eSpark-Consulting-Group/kurtvogel-athletitech-hw/docs/Client-Files/Original Design/Athletitech/AthletitechTop.png

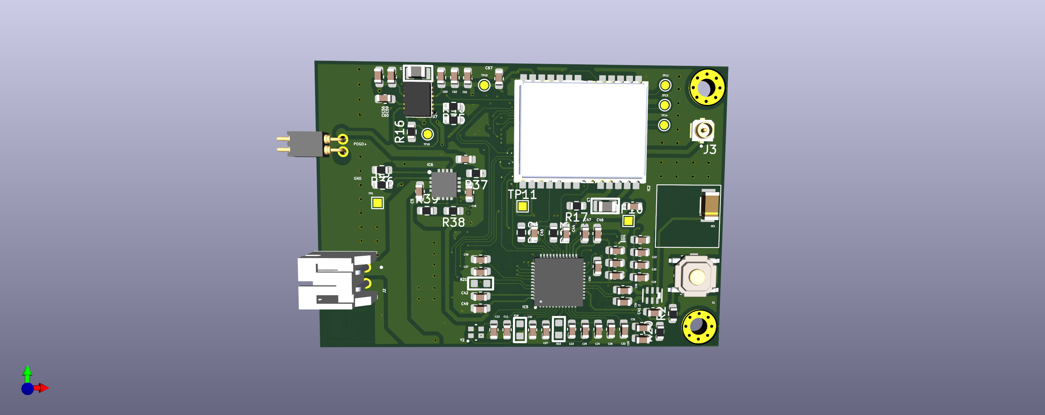
docs/Client-Files/Original Design/Athletitech/AthletitechTop.png
