eSpark-Consulting-Group/kurtvogel-athletitech-hw/docs/Client-Files/Original Design/Athletitech/AthletitechSide.png

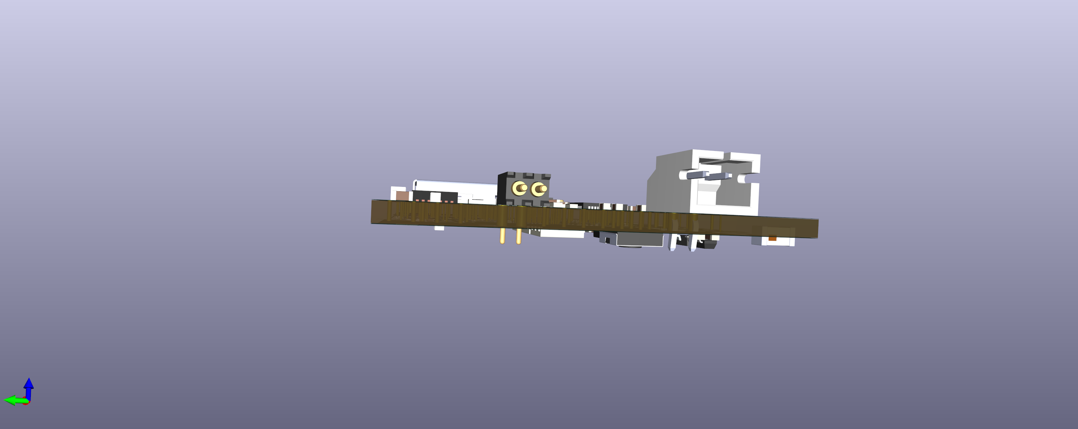
docs/Client-Files/Original Design/Athletitech/AthletitechSide.png
