eSpark-Consulting-Group/kurtvogel-athletitech-hw/README.md

# Athletitech Product Hardware Development and Enhancements
#### Client Name: Kurt Vogel

## Project Requirements
Outlined in Tickets
