eSpark-Consulting-Group/kurtvogel-athletitech-hw/docs/Client-Files/Original Design/Athletitech/AthletitechBottom.png

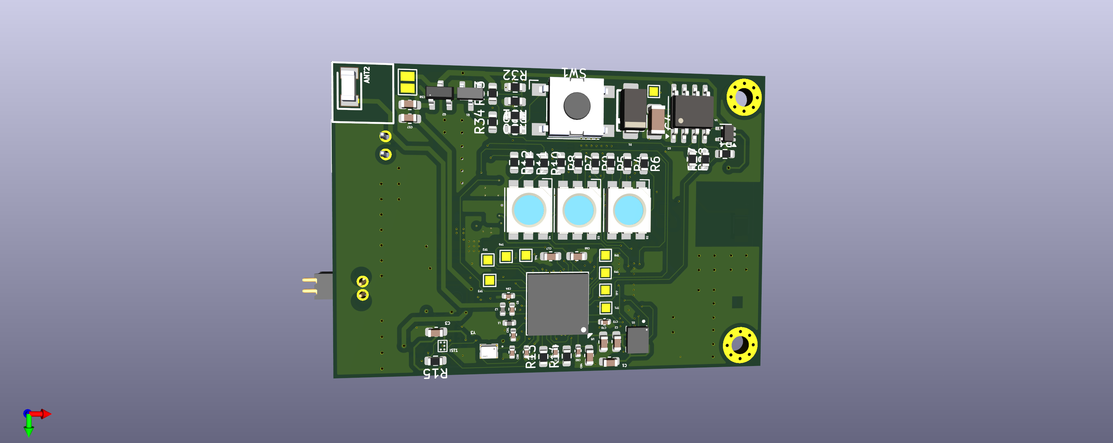
docs/Client-Files/Original Design/Athletitech/AthletitechBottom.png
