eSpark-Consulting-Group/kurtvogel-athletitech-hw/docs/Client-Files/Original Design/Athletitech/pcbway_production/2025-01-10-14-01-19/Athletitech.kicad_pcb_bom.csv

Designator | Quantity | Value | Footprint | Package | MPN | DNP | Mount_Type | MANUFACTURER_NAME | MF | MOUSER_PRICE-STOCK | DESCRIPTION | MOUSER_PART_NUMBER | Price | Check_prices | HEIGHT | MP | SnapEDA_Link | ARROW_PRICE-STOCK | ARROW_PART_NUMBER | Description_1 | Availability | MANUFACTURER_PART_NUMBER | Description | Field4 | Field5 | Field6 | Field7 | Field8 | Part Description | Digikey | LCSC Part # | Manufacturer | Height | Manufacturer_Name | Mouser Part Number | Mouser Price/Stock | Arrow Part Number | Arrow Price/Stock | Purchase-URL | Sim.Device | Sim.Type | Sim.Pins | PARTREV | STANDARD | MAXIMUM_PACKAGE_HEIGHT | MANUFACTURER | MNP
ANT2 | 1 | 2450AT18B100E | ANTC3216X140N | None |  |  | smt | JOHANSON TECHNOLOGY | Johanson | https://www.mouser.co.uk/ProductDetail/Johanson-Technology/2450AT18B100E?qs=yCnrNFeXz%252Bh5MFsFIXGZGA%3D%3D | Antennas 2.45GHz ANTENNA | 609-2450AT18B100E | None | https://www.snapeda.com/parts/2450AT18B100E/AN/view-part/?ref=eda | 1.4mm | 2450AT18B100E | https://www.snapeda.com/parts/2450AT18B100E/AN/view-part/?ref=snap | https://www.arrow.com/en/products/2450at18b100e/johanson-dielectrics?region=nac | 2450AT18B100E | Antenna Chip -0.5dBi Gain 2500MHz 2-Pin CSMD T/R | In Stock | 2450AT18B100E
C1, C2, C3, C43 | 4 | 100nF | C_0402_1005Metric |  |  |  | smt |  |  |  |  |  |  |  |  |  |  |  |  |  |  |  | Unpolarized capacitor, small symbol | Farnell | 2611911 | RM EMK105 B7104KV-F | TAIYO YUDEN EUROPE GMBH | 110091611 | 0.1uF 10% 16V Ceramic Capacitor X7R 0402 (1005 Metric)
C11, C12 | 2 | 10pF | C_0402_1005Metric |  | 04025C222K4T4A |  | smt |  |  |  |  |  |  |  |  |  |  |  |  |  |  |  |  | Farnell | 2611911 | RM EMK105 B7104KV-F | TAIYO YUDEN EUROPE GMBH | 110091611 | 0.1uF 10% 16V Ceramic Capacitor X7R 0402 (1005 Metric)
C17, C66 | 2 | 4.7uF | C_0402_1005Metric |  | C1005X7R1C104K050BC |  | smt |  |  |  |  |  |  |  |  |  |  |  |  |  |  |  | Unpolarized capacitor, small symbol | Farnell | 2611911 | RM EMK105 B7104KV-F | TAIYO YUDEN EUROPE GMBH | 110091611 | 0.1uF 10% 16V Ceramic Capacitor X7R 0402 (1005 Metric)
C18, C67 | 2 | 100nf | C_0402_1005Metric |  | C1005X7R1C104K050BC |  | smt |  |  |  |  |  |  |  |  |  |  |  |  |  |  |  | Unpolarized capacitor, small symbol | Farnell | 2611911 | RM EMK105 B7104KV-F | TAIYO YUDEN EUROPE GMBH | 110091611 | 0.1uF 10% 16V Ceramic Capacitor X7R 0402 (1005 Metric)
C19 | 1 | 47uf | C_0402_1005Metric |  | JMK316ABJ476ML8T |  | smt |  |  |  |  |  |  |  |  |  |  |  |  |  |  |  | Unpolarized capacitor, small symbol | Farnell | 2611911 | RM EMK105 B7104KV-F | TAIYO YUDEN EUROPE GMBH | 110091611 | 0.1uF 10% 16V Ceramic Capacitor X7R 0402 (1005 Metric)
C20, C24, C26, C32, C33, C37, C38, C39, C42, C44, C45, C46, C47, C49 | 14 | 100nf | C_0402_1005Metric |  | TMK105B7104KVHF |  | smt |  |  |  |  |  |  |  |  |  |  |  |  |  |  |  | Unpolarized capacitor, small symbol | Farnell | 2611911 | RM EMK105 B7104KV-F | TAIYO YUDEN EUROPE GMBH | 110091611 | 0.1uF 10% 16V Ceramic Capacitor X7R 0402 (1005 Metric)
C22, C34 | 2 | 10pf | C_0402_1005Metric |  | KGM05ACG1H100JH |  | smt |  |  |  |  |  |  |  |  |  |  |  |  |  |  |  | Unpolarized capacitor, small symbol | Farnell | 2611911 | RM EMK105 B7104KV-F | TAIYO YUDEN EUROPE GMBH | 110091611 | 0.1uF 10% 16V Ceramic Capacitor X7R 0402 (1005 Metric)
C23 | 1 | 27pf | C_0402_1005Metric |  | VJ0402A270JXQPW1BC |  | smt |  |  |  |  |  |  |  |  |  |  |  |  |  |  |  | Unpolarized capacitor, small symbol | Farnell | 2611911 | RM EMK105 B7104KV-F | TAIYO YUDEN EUROPE GMBH | 110091611 | 0.1uF 10% 16V Ceramic Capacitor X7R 0402 (1005 Metric)
C25 | 1 | 1P2 | C_0402_1005Metric |  | GRM0225C1H1R2CA03L |  | smt |  |  |  |  |  |  |  |  |  |  |  |  |  |  |  | Unpolarized capacitor, small symbol | Farnell | 2611911 | RM EMK105 B7104KV-F | TAIYO YUDEN EUROPE GMBH | 110091611 | 0.1uF 10% 16V Ceramic Capacitor X7R 0402 (1005 Metric)
C27, C30, C60 | 3 | 100nF | C_0402_1005Metric |  | CL10B104KA8WPNC |  | smt |  |  |  |  |  |  |  |  |  |  |  |  |  |  |  | Unpolarized capacitor, small symbol | Farnell | 2611911 | RM EMK105 B7104KV-F | TAIYO YUDEN EUROPE GMBH | 110091611 | 0.1uF 10% 16V Ceramic Capacitor X7R 0402 (1005 Metric)
C28, C40 | 2 | 330pf | C_0402_1005Metric |  | MAASU105SB7331KFCA01 |  | smt |  |  |  |  |  |  |  |  |  |  |  |  |  |  |  | Unpolarized capacitor, small symbol | Farnell | 2611911 | RM EMK105 B7104KV-F | TAIYO YUDEN EUROPE GMBH | 110091611 | 0.1uF 10% 16V Ceramic Capacitor X7R 0402 (1005 Metric)
C29 | 1 | 820pf | C_0402_1005Metric |  | UMK105B7821KV-F |  | smt |  |  |  |  |  |  |  |  |  |  |  |  |  |  |  | Unpolarized capacitor, small symbol | Farnell | 2611911 | RM EMK105 B7104KV-F | TAIYO YUDEN EUROPE GMBH | 110091611 | 0.1uF 10% 16V Ceramic Capacitor X7R 0402 (1005 Metric)
C31 | 1 | 18pf | C_0402_1005Metric |  | VJ0402A180KXQCW1BC |  | smt |  |  |  |  |  |  |  |  |  |  |  |  |  |  |  | Unpolarized capacitor, small symbol | Farnell | 2611911 | RM EMK105 B7104KV-F | TAIYO YUDEN EUROPE GMBH | 110091611 | 0.1uF 10% 16V Ceramic Capacitor X7R 0402 (1005 Metric)
C35, C36, C68, C69 | 4 | 12pf | C_0402_1005Metric |  | CBR04C120J5GACAUTO |  | smt |  |  |  |  |  |  |  |  |  |  |  |  |  |  |  | Unpolarized capacitor, small symbol | Farnell | 2611911 | RM EMK105 B7104KV-F | TAIYO YUDEN EUROPE GMBH | 110091611 | [C35,C36] 0.1uF 10% 16V Ceramic Capacitor X7R 0402 (1005 Metric); [C68,C69]0.1 µF ±10% 16V Ceramic Capacitor X7R 0402 (1005 Metric) | 587-1451-1-ND | C385888 | Taiyo Yuden
C4 | 1 | 1uF | C_1206 |  |  |  | smt |  |  |  |  |  |  |  |  |  |  |  |  |  |  |  | Polarized capacitor
C41 | 1 | 10000pf | C_0402_1005Metric |  | KAM05AR71E103KH |  | smt |  |  |  |  |  |  |  |  |  |  |  |  |  |  |  | Unpolarized capacitor, small symbol | Farnell | 2611911 | RM EMK105 B7104KV-F | TAIYO YUDEN EUROPE GMBH | 110091611 | 0.1uF 10% 16V Ceramic Capacitor X7R 0402 (1005 Metric)
C48, C5 | 2 | 470nF | C_0402_1005Metric |  |  |  | smt |  |  |  |  |  |  |  |  |  |  |  |  |  |  |  | Unpolarized capacitor, small symbol | Farnell | 2611911 | RM EMK105 B7104KV-F | TAIYO YUDEN EUROPE GMBH | 110091611 | 0.1uF 10% 16V Ceramic Capacitor X7R 0402 (1005 Metric)
C56, C59 | 2 | 10uF | C_0402_1005Metric |  | CL10A106MQ8NNNC |  | smt |  |  |  |  |  |  |  |  |  |  |  |  |  |  |  | Unpolarized capacitor, small symbol | Farnell | 2611911 | RM EMK105 B7104KV-F | TAIYO YUDEN EUROPE GMBH | 110091611 | 0.1uF 10% 16V Ceramic Capacitor X7R 0402 (1005 Metric)
C57 | 1 | 10uF/25V | C_0402_1005Metric |  |  |  | smt |  |  |  |  |  |  |  |  |  |  |  |  |  |  |  | Unpolarized capacitor, small symbol | Farnell | 2611911 | RM EMK105 B7104KV-F | TAIYO YUDEN EUROPE GMBH | 110091611 | 0.1uF 10% 16V Ceramic Capacitor X7R 0402 (1005 Metric)
C58 | 1 | 0.1uF/25V | C_0402_1005Metric |  | CL10B104KA8NFNC |  | smt |  |  |  |  |  |  |  |  |  |  |  |  |  |  |  | Unpolarized capacitor, small symbol | Farnell | 2611911 | RM EMK105 B7104KV-F | TAIYO YUDEN EUROPE GMBH | 110091611 | 0.1uF 10% 16V Ceramic Capacitor X7R 0402 (1005 Metric)
C6 | 1 | 1.2pF | C_0402_1005Metric |  | CC0402DRNPO9BN5R0 |  | smt |  |  |  |  |  |  |  |  |  |  |  |  |  |  |  | Unpolarized capacitor, small symbol | Farnell | 2611911 | RM EMK105 B7104KV-F | TAIYO YUDEN EUROPE GMBH | 110091611 | 0.1 µF ±10% 16V Ceramic Capacitor X7R 0402 (1005 Metric) | 587-1451-1-ND | C385888 | Taiyo Yuden
C61, C62, C63 | 3 | 22uf | C_0402_1005Metric |  | LMK212BBJ226MG-T |  | smt |  |  |  |  |  |  |  |  |  |  |  |  |  |  |  | Unpolarized capacitor, small symbol | Farnell | 2611911 | RM EMK105 B7104KV-F | TAIYO YUDEN EUROPE GMBH | 110091611 | 0.1uF 10% 16V Ceramic Capacitor X7R 0402 (1005 Metric)
C64 | 1 | 820pF | C_0402_1005Metric |  | CC0402DRNPO9BN5R0 |  | smt |  |  |  |  |  |  |  |  |  |  |  |  |  |  |  | Unpolarized capacitor, small symbol | Farnell | 2611911 | RM EMK105 B7104KV-F | TAIYO YUDEN EUROPE GMBH | 110091611 | 0.1 µF ±10% 16V Ceramic Capacitor X7R 0402 (1005 Metric) | 587-1451-1-ND | C385888 | Taiyo Yuden
C7, C8, C9 | 3 | 0.1uF | C_0402_1005Metric |  | CC0402DRNPO9BN5R0 |  | smt |  |  |  |  |  |  |  |  |  |  |  |  |  |  |  | Unpolarized capacitor, small symbol | Farnell | 2611911 | RM EMK105 B7104KV-F | TAIYO YUDEN EUROPE GMBH | 110091611 | 0.1uF 10% 16V Ceramic Capacitor X7R 0402 (1005 Metric)
C70 | 1 | 1uF | C_0402_1005Metric |  | CC0402DRNPO9BN5R0 |  | smt |  |  |  |  |  |  |  |  |  |  |  |  |  |  |  | Unpolarized capacitor, small symbol | Farnell | 2611911 | RM EMK105 B7104KV-F | TAIYO YUDEN EUROPE GMBH | 110091611 | 0.1uF 10% 16V Ceramic Capacitor X7R 0402 (1005 Metric)
C71, C82 | 2 | NC | C_0402_1005Metric |  | CC0402DRNPO9BN5R0 |  | smt |  |  |  |  |  |  |  |  |  |  |  |  |  |  |  | Unpolarized capacitor, small symbol | Farnell | 2611911 | RM EMK105 B7104KV-F | TAIYO YUDEN EUROPE GMBH | 110091611 | 0.1 µF ±10% 16V Ceramic Capacitor X7R 0402 (1005 Metric) | 587-1451-1-ND | C385888 | Taiyo Yuden
C72 | 1 | 100nF | C_0402_1005Metric |  | CC0402DRNPO9BN5R0 |  | smt |  |  |  |  |  |  |  |  |  |  |  |  |  |  |  | Unpolarized capacitor, small symbol | Farnell | 2611911 | RM EMK105 B7104KV-F | TAIYO YUDEN EUROPE GMBH | 110091611 | 0.1 µF ±10% 16V Ceramic Capacitor X7R 0402 (1005 Metric) | 587-1451-1-ND | C385888 | Taiyo Yuden
C81 | 1 | 100pf | C_0402_1005Metric |  | CC0402DRNPO9BN5R0 |  | smt |  |  |  |  |  |  |  |  |  |  |  |  |  |  |  | Unpolarized capacitor, small symbol | Farnell | 2611911 | RM EMK105 B7104KV-F | TAIYO YUDEN EUROPE GMBH | 110091611 | 0.1 µF ±10% 16V Ceramic Capacitor X7R 0402 (1005 Metric) | 587-1451-1-ND | C385888 | Taiyo Yuden
C84 | 1 | 1uF | C_0402_1005Metric |  | C1005X7R1C104K050BC |  | smt |  |  |  |  |  |  |  |  |  |  |  |  |  |  |  | Unpolarized capacitor, small symbol | Farnell | 2611911 | RM EMK105 B7104KV-F | TAIYO YUDEN EUROPE GMBH | 110091611 | 0.1uF 10% 16V Ceramic Capacitor X7R 0402 (1005 Metric)
D1 | 1 | B120-E3 | D_SMA |  |  |  | smt |  |  |  |  |  |  |  |  |  |  |  |  |  |  |  | 20V 1A Schottky Barrier Rectifier Diode, SMA(DO-214AC)
D2, D3, D4 | 3 | SMD-LX5050RGB-TR | LED_RGB_5050-6 |  |  |  | smt
IC2 | 1 | NEO-M9N-00B | NEOM9N00B |  | NEO-M9N-00B |  | smt |  |  |  |  |  |  |  |  |  |  |  |  |  |  |  | M9 RF Receiver BeiDou, Galileo, GLONASS, GNSS, GPS -167dBm Module |  |  |  |  |  |  |  |  |  | 2.6 | u-blox | 377-NEO-M9N-00B | https://www.mouser.co.uk/ProductDetail/u-blox/NEO-M9N-00B?qs=DPoM0jnrROVeJ6BHpcwcjw%3D%3D | NEO-M9N-00B | https://www.arrow.com/en/products/neo-m9n-00b/u-blox?utm_currency=USD&region=nac
IC5 | 1 | DW1000-I-TR13 | QFN40P600X600X90-49N-D |  | DW1000-I-TR13 |  | smt |  |  |  |  |  |  |  |  |  |  |  |  |  |  |  |  |  |  |  |  |  |  |  |  |  | 0.9 | Qorvo | 772-DW1000-I-TR13 | https://www.mouser.co.uk/ProductDetail/Qorvo/DW1000-I-TR13?qs=TiOZkKH1s2SHqHtNDSAfuQ%3D%3D
IC6 | 1 | BQ24075RGTT | QFN50P300X300X80-17N-D |  | BQ24075RGTT |  | smt |  |  |  |  |  |  |  |  |  |  |  |  |  |  |  | 1.5A Li-Ion Charger, Power-Path VQFN16EP BQ24075RGTT, Battery Charge Controller, Lithium-Ion, 4500mA, 16-Pin QFN |  |  |  |  |  |  |  |  |  | 0.8 | Texas Instruments | 595-BQ24075RGTT | https://www.mouser.co.uk/ProductDetail/Texas-Instruments/BQ24075RGTT?qs=XGzIaZb%2FFYI%2FchYUGCJQgg%3D%3D | BQ24075RGTT | null?region=nac
J2 | 1 | S2B-PH-K-S | S2BPHKS |  | S2B-PH-K-S |  | tht |  |  |  |  |  |  |  |  |  |  |  |  |  |  |  | CONN HEADER R/A 2POS 2MM |  |  |  |  |  |  |  |  |  | 4.8 | JST (JAPAN SOLDERLESS TERMINALS)
J3 | 1 | CONMHF4-SMD-G-T | LINX_CONMHF4-SMD-G-T | None |  |  | smt |  | TE Connectivity |  |  |  | None | https://www.snapeda.com/parts/CONMHF4-SMD-G-T/TE+Connectivity/view-part/?ref=eda |  | CONMHF4-SMD-G-T | https://www.snapeda.com/parts/CONMHF4-SMD-G-T/TE+Connectivity/view-part/?ref=snap |  |  | MHF4 Jack 50 Ohm PCB Surface Mount | In Stock |  |  |  |  |  |  |  |  |  |  |  |  |  |  |  |  |  | https://www.snapeda.com/api/url_track_click_mouser/?unipart_id=9180174&manufacturer=Linx Technologies Inc.&part_name=CONMHF4-SMD-G-T&search_term=None
JP1 | 1 | Jumper_2_Open | SolderJumper-2_P1.3mm_Open_Pad1.0x1.5mm |  |  |  | tht |  |  |  |  |  |  |  |  |  |  |  |  |  |  |  | Jumper, 2-pole, open
L1 | 1 | 2.7nH | L_0402_1005Metric |  | MHQ1005P4N7ST000 |  | smt |  |  |  |  |  |  |  |  |  |  |  |  |  |  |  | Inductor, small symbol
L2 | 1 | 3.3nH | L_0402_1005Metric |  | MHQ1005P4N7ST000 |  | smt |  |  |  |  |  |  |  |  |  |  |  |  |  |  |  | Inductor, small symbol
L3 | 1 | 27nH | C_0402_1005Metric |  | MHQ1005P4N7ST000 |  | smt |  |  |  |  |  |  |  |  |  |  |  |  |  |  |  | Inductor, small symbol | Farnell | 2611911 | RM EMK105 B7104KV-F | TAIYO YUDEN EUROPE GMBH | 110091611 | 0.1uF 10% 16V Ceramic Capacitor X7R 0402 (1005 Metric)
L5 | 1 | 1.5uH | L_0805 |  | 0805LS-102XJRC |  | smt |  |  |  |  |  |  |  |  |  |  |  |  |  |  |  | Inductor
Q1 | 1 | FDN337N | SOT23-3 |  | FDN337N |  | smt |  |  |  |  |  |  |  |  |  |  |  |  |  |  |  |  |  |  |  |  |  |  |  |  |  | 1.12 | onsemi | 512-FDN337N | https://www.mouser.co.uk/ProductDetail/onsemi-Fairchild/FDN337N?qs=FOlmdCx%252BAA3j%252BaaebyVFog%3D%3D
Q2 | 1 | NTR4101PT1G | SOT23-3 |  |  |  | smt |  |  |  |  |  |  |  |  |  |  |  |  |  |  |  | P-MOSFET transistor, drain/source/gate |  |  |  |  |  |  |  |  |  |  |  |  |  |  |  |  | PMOS | VDMOS | 1=D 2=G 3=S
R1 | 1 | 1k | C_0402_1005Metric |  | CRCW040210K0FKEDC |  | smt |  |  |  |  |  |  |  |  |  |  |  |  |  |  |  |  | Farnell | 2611911 | RM EMK105 B7104KV-F | TAIYO YUDEN EUROPE GMBH | 110091611 | 0.1uF 10% 16V Ceramic Capacitor X7R 0402 (1005 Metric)
R13, R14 | 2 | 4k7 | C_0402_1005Metric |  | CRCW04021K00FKED |  | smt |  |  |  |  |  |  |  |  |  |  |  |  |  |  |  | Resistor, small symbol | Farnell | 2611911 | RM EMK105 B7104KV-F | TAIYO YUDEN EUROPE GMBH | 110091611 | 0.1uF 10% 16V Ceramic Capacitor X7R 0402 (1005 Metric)
R15 | 1 | 1k2 | C_0402_1005Metric |  | CRCW04021K00FKED |  | smt |  |  |  |  |  |  |  |  |  |  |  |  |  |  |  | Resistor, small symbol | Farnell | 2611911 | RM EMK105 B7104KV-F | TAIYO YUDEN EUROPE GMBH | 110091611 | 0.1uF 10% 16V Ceramic Capacitor X7R 0402 (1005 Metric)
R16, R40 | 2 | 1M | C_0402_1005Metric |  | CRCW04021M00FKED |  | smt |  |  |  |  |  |  |  |  |  |  |  |  |  |  |  | Resistor, small symbol | Farnell | 2611911 | RM EMK105 B7104KV-F | TAIYO YUDEN EUROPE GMBH | 110091611 | 0.1uF 10% 16V Ceramic Capacitor X7R 0402 (1005 Metric)
R17 | 1 | 10Ω | C_0402_1005Metric |  | CRCW04021K00FKED |  | smt |  |  |  |  |  |  |  |  |  |  |  |  |  |  |  | Resistor, small symbol | Farnell | 2611911 | RM EMK105 B7104KV-F | TAIYO YUDEN EUROPE GMBH | 110091611 | 0.1uF 10% 16V Ceramic Capacitor X7R 0402 (1005 Metric)
R18 | 1 | 11K | C_0402_1005Metric |  | RC0402FR-0711KL |  | smt |  |  |  |  |  |  |  |  |  |  |  |  |  |  |  | Resistor, small symbol | Farnell | 2611911 | RM EMK105 B7104KV-F | TAIYO YUDEN EUROPE GMBH | 110091611 | 0.1uF 10% 16V Ceramic Capacitor X7R 0402 (1005 Metric)
R19 | 1 | 16K | C_0402_1005Metric |  | CRCW040216K0FKED |  | smt |  |  |  |  |  |  |  |  |  |  |  |  |  |  |  | Resistor, small symbol | Farnell | 2611911 | RM EMK105 B7104KV-F | TAIYO YUDEN EUROPE GMBH | 110091611 | 0.1uF 10% 16V Ceramic Capacitor X7R 0402 (1005 Metric)
R2 | 1 | 1K | C_0402_1005Metric |  | CRCW04021K00FKED |  | smt |  |  |  |  |  |  |  |  |  |  |  |  |  |  |  | Resistor, small symbol | Farnell | 2611911 | RM EMK105 B7104KV-F | TAIYO YUDEN EUROPE GMBH | 110091611 | 0.1uF 10% 16V Ceramic Capacitor X7R 0402 (1005 Metric)
R20 | 1 | 270 | C_0402_1005Metric |  | CRCW0402270RJNED |  | smt |  |  |  |  |  |  |  |  |  |  |  |  |  |  |  | Resistor, small symbol | Farnell | 2611911 | RM EMK105 B7104KV-F | TAIYO YUDEN EUROPE GMBH | 110091611 | 0.1uF 10% 16V Ceramic Capacitor X7R 0402 (1005 Metric)
R21 | 1 | 100K | C_0402_1005Metric |  | CRCW0603100KFKEE |  | smt |  |  |  |  |  |  |  |  |  |  |  |  |  |  |  | Resistor, small symbol | Farnell | 2611911 | RM EMK105 B7104KV-F | TAIYO YUDEN EUROPE GMBH | 110091611 | 0.1uF 10% 16V Ceramic Capacitor X7R 0402 (1005 Metric)
R22, R23, R27, R28, R34 | 5 | 10K | C_0402_1005Metric |  | CRCW040210K0FKEDC |  | smt |  |  |  |  |  |  |  |  |  |  |  |  |  |  |  | Resistor, small symbol | Farnell | 2611911 | RM EMK105 B7104KV-F | TAIYO YUDEN EUROPE GMBH | 110091611 | 0.1uF 10% 16V Ceramic Capacitor X7R 0402 (1005 Metric)
R24 | 1 | 330R | C_0402_1005Metric |  | CRCW04021K00FKED |  | smt |  |  |  |  |  |  |  |  |  |  |  |  |  |  |  | Resistor, small symbol | Farnell | 2611911 | RM EMK105 B7104KV-F | TAIYO YUDEN EUROPE GMBH | 110091611 | 0.1uF 10% 16V Ceramic Capacitor X7R 0402 (1005 Metric)
R29, R32, R33 | 3 | 100K | C_0402_1005Metric |  | ERJ-2RKF1003X |  | smt |  |  |  |  |  |  |  |  |  |  |  |  |  |  |  | Resistor | Farnell | 2611911 | RM EMK105 B7104KV-F | TAIYO YUDEN EUROPE GMBH | 110091611 | 0.1uF 10% 16V Ceramic Capacitor X7R 0402 (1005 Metric)
R3 | 1 | 10kΩ | C_0402_1005Metric |  |  |  | smt |  |  |  |  |  |  |  |  |  |  |  |  |  |  |  | Resistor | Farnell | 2611911 | RM EMK105 B7104KV-F | TAIYO YUDEN EUROPE GMBH | 110091611 | 0.1uF 10% 16V Ceramic Capacitor X7R 0402 (1005 Metric)
R30 | 1 | 220 | C_0402_1005Metric |  |  |  | smt |  |  |  |  |  |  |  |  |  |  |  |  |  |  |  | Resistor | Farnell | 2611911 | RM EMK105 B7104KV-F | TAIYO YUDEN EUROPE GMBH | 110091611 | 0.1uF 10% 16V Ceramic Capacitor X7R 0402 (1005 Metric)
R31 | 1 | DNP | C_0402_1005Metric |  |  | Yes | smt |  |  |  |  |  |  |  |  |  |  |  |  |  |  |  | Resistor | Farnell | 2611911 | RM EMK105 B7104KV-F | TAIYO YUDEN EUROPE GMBH | 110091611 | 0.1uF 10% 16V Ceramic Capacitor X7R 0402 (1005 Metric)
R35 | 1 | 180K | C_0402_1005Metric |  | ERJ-2RKD1803X |  | smt |  |  |  |  |  |  |  |  |  |  |  |  |  |  |  | Resistor, small symbol | Farnell | 2611911 | RM EMK105 B7104KV-F | TAIYO YUDEN EUROPE GMBH | 110091611 | 0.1uF 10% 16V Ceramic Capacitor X7R 0402 (1005 Metric)
R36 | 1 | 1.13kΩ | C_0402_1005Metric |  |  |  | smt |  |  |  |  |  |  |  |  |  |  |  |  |  |  |  | Resistor | Farnell | 2611911 | RM EMK105 B7104KV-F | TAIYO YUDEN EUROPE GMBH | 110091611 | 0.1uF 10% 16V Ceramic Capacitor X7R 0402 (1005 Metric)
R37 | 1 | 1.18kΩ | C_0402_1005Metric |  |  |  | smt |  |  |  |  |  |  |  |  |  |  |  |  |  |  |  | Resistor | Farnell | 2611911 | RM EMK105 B7104KV-F | TAIYO YUDEN EUROPE GMBH | 110091611 | 0.1uF 10% 16V Ceramic Capacitor X7R 0402 (1005 Metric)
R38, R39 | 2 | 100kΩ | C_0402_1005Metric |  |  |  | smt |  |  |  |  |  |  |  |  |  |  |  |  |  |  |  | Resistor | Farnell | 2611911 | RM EMK105 B7104KV-F | TAIYO YUDEN EUROPE GMBH | 110091611 | 0.1uF 10% 16V Ceramic Capacitor X7R 0402 (1005 Metric)
S1 | 1 | EVQ-PT5A15 | EVQPT5A15 |  | EVQ-PT5A15 |  | smt |  |  |  |  |  |  |  |  |  |  |  |  |  |  |  | Tactile Switches SPST-NO Force 1 N w/ Push Plate 1.5mmH |  |  |  |  |  |  |  |  |  | 1.5 | Panasonic | 667-EVQ-PT5A15 | https://www.mouser.co.uk/ProductDetail/Panasonic/EVQ-PT5A15?qs=8CJXEYeWfIoXP%252BpSCMezSA%3D%3D | EVQ-PT5A15 | https://www.arrow.com/en/products/evqpt5a15/panasonic
SG-WFWLB1 | 1 | TLV493DA2BWXTMA1 | SG-WFWLB-5-2 |  |  |  | smt
SW1 | 1 | SW_Omron_B3FS | SW_SPST_Omron_B3FS-100xP |  |  |  | smt |  |  |  |  |  |  |  |  |  |  |  |  |  |  |  | Omron B3FS 6x6mm single pole normally-open tactile switch
T1 | 1 | HHM1595A1 | HHM-6_2P0X1P25 |  | HHM1595A1 |  | smt |  |  |  |  |  |  |  |  |  |  |  |  |  |  |  |  |  |  |  |  |  |  |  |  |  |  | TDK | 810-HHM1595A1 | https://www.mouser.co.uk/ProductDetail/TDK/HHM1595A1?qs=CQ%2FIPMfstfij2T2%252BDRqDhg%3D%3D | HHM1595A1 | https://www.arrow.com/en/products/hhm1595a1/tdk
TP1, TP10, TP11, TP17, TP2, TP3, TP4, TP5, TP6, TP7, TP8, TP9 | 12 | TestPoint | TestPoint_Pad_1.0x1.0mm |  |  |  | tht |  |  |  |  |  |  |  |  |  |  |  |  |  |  |  | test point
TP12, TP13, TP14, TP18 | 4 | TestPoint | TestPoint_Pad_D1.0mm |  |  |  | tht |  |  |  |  |  |  |  |  |  |  |  |  |  |  |  | test point
TP19 | 1 | Power Good | TestPoint_Pad_D1.0mm |  |  |  | tht |  |  |  |  |  |  |  |  |  |  |  |  |  |  |  | test point
U1 | 1 | ICM-45686 | IC_ICM-45686 |  |  |  | smt |  |  |  |  |  |  |  |  |  |  |  |  |  |  |  |  |  |  |  |  |  |  |  |  |  |  |  |  |  |  |  |  |  |  |  | 0.2 | Manufacturer Recommendations | 0.86mm | TDK InvenSense
U3 | 1 | TLC555I | SOIC-8_3.9x4.9mm_P1.27mm |  |  |  | smt |  |  |  |  |  |  |  |  |  |  |  |  |  |  |  | Precision Timers, 555 compatible, SOIC-8
U4 | 1 | 74AUP1G06, DNP | SOT-353_SC-70-5 |  |  |  | smt |  |  |  |  |  |  |  |  |  |  |  |  |  |  |  | Single NOT Gate, Open Drain, Low-Voltage CMOS |  |  |  |  |  |  |  |  |  |  |  |  |  |  |  |  |  |  |  |  |  |  |  | DNP
U5 | 1 | nRF52840 | Nordic_AQFN-73-1EP_7x7mm_P0.5mm |  |  |  | smt |  |  |  |  |  |  |  |  |  |  |  |  |  |  |  | Multiprotocol BLE/ANT/2.4 GHz/802.15.4 Cortex-M4F SoC, AQFN-73
U7 | 1 | TPS63020 | QFN14-3X4MM | None |  |  | smt |  | Texas Instruments |  |  |  | None | https://www.snapeda.com/parts/TPS63020/Texas+Instruments/view-part/?ref=eda |  | TPS63020 | https://www.snapeda.com/parts/TPS63020/Texas+Instruments/view-part/?ref=snap |  |  | Buck-Boost Switching Regulator IC Positive Adjustable 1.2V 1 Output 3.5A (Switch) 14-VFDFN Exposed Pad | Not in stock
U8 | 1 | ~ | Mill_Max_854-22-002-20-041101 |  |  |  | tht
Y2 | 1 | 8Y38472012 | 8Y384_TXC |  | 8Y38472012 |  | smt |  |  |  |  |  |  |  |  |  |  |  |  |  |  |  |  |  |  |  |  |  |  |  |  |  | 0.5 | TXC CORPORATION
Y3 | 1 | XRCGB32M000F1S1DR0 | XRCGB |  | XRCGB32M000F1S1DR0 |  | smt |  |  |  |  |  |  |  |  |  |  |  |  |  |  |  | 32 MHz +/-10ppm Crystal 12pF 50 Ohms 4-SMD, No Lead |  |  |  |  |  |  |  |  |  | 0.7 | Murata Electronics | 81-XRCGB32M000F1S1DR | https://www.mouser.co.uk/ProductDetail/Murata-Electronics/XRCGB32M000F1S1DR0?qs=ljCeji4nMDlwheuyeMwwTQ%3D%3D
