eSpark-Consulting-Group/kurtvogel-athletitech-hw/docs/Client-Files/Original Design/Athletitech/3D/NEO-M9N-00B.stp

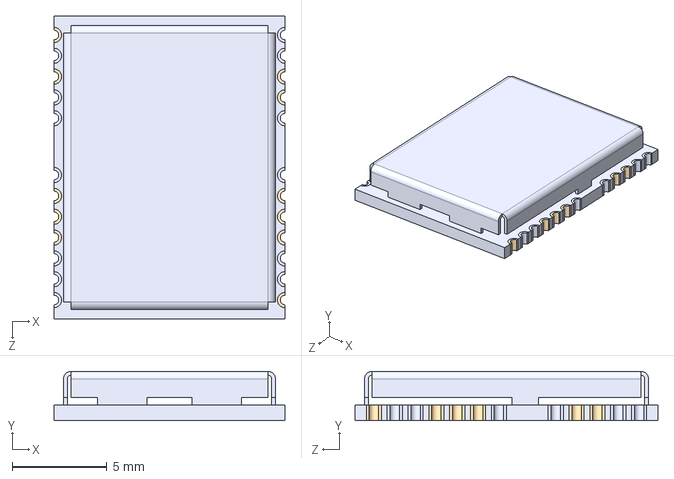
[picture p4: CAD file, 2025-04-07]
docs/Client-Files/Original Design/Athletitech/3D/NEO-M9N-00B.stp
12.2 x 2.60 x 16.0 mm
