eSpark-Consulting-Group/kurtvogel-athletitech-hw/docs/Client-Files/Original Design/Athletitech/Athletitech_3D_PCB/Athletitech.step

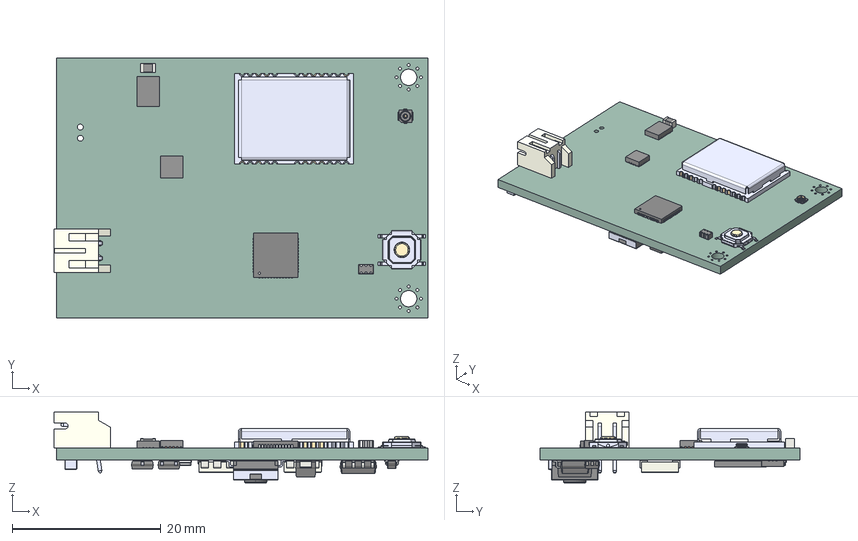
[picture p5: CAD file, 2025-04-07]
docs/Client-Files/Original Design/Athletitech/Athletitech_3D_PCB/Athletitech.step
50.3 x 35.0 x 9.50 mm
TPS63020
~$SKQGADE010--3DModel-STEP-56544
RGT0016B_ASM
L_0805_2012Metric
S2B-PH-K-S(LF)(SN)
CONMHF4-SMD-G-T
HHM1595A1
NEO-M9N-00B
LED_RGB_5050_6 x 3
logo
dot
pins
SOT_353_SC_70_5
NRF52840-QIAA-R7
D_SMA
L_0402_1005Metric x 2
FDN352AP x 2
ICM-45686
SOIC_8_39x49mm_P127mm
2450AT18B100E
B3FS-1000P
_autosave-Athletitech_PCB
