eSpark-Consulting-Group/kurtvogel-athletitech-hw/docs/Client-Files/Original Design/Athletitech/3D/SKQGABE010.stp

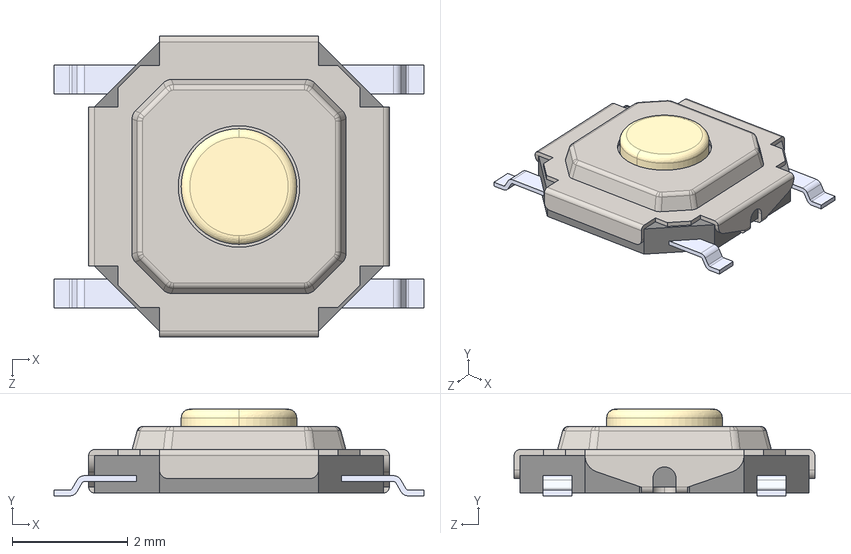
[picture p6: CAD file, 2025-04-07]
docs/Client-Files/Original Design/Athletitech/3D/SKQGABE010.stp
6.40 x 1.50 x 5.20 mm
SKQGADE010
SKQGADE010_4
SKQGADE010_3
SKQGADE010_7
SKQGADE010_2
SKQGADE010_6
SKQGADE010_5
