eSpark-Consulting-Group/kurtvogel-athletitech-hw/docs/Client-Files/Original Design/Athletitech/3D/HHM1595A1.stp

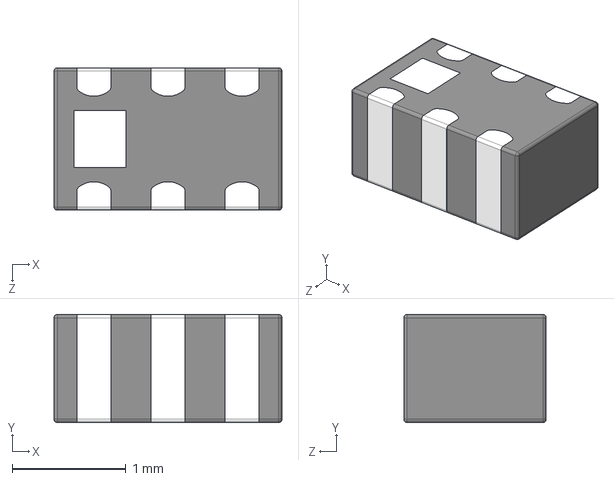
[picture p7: CAD file, 2025-04-07]
docs/Client-Files/Original Design/Athletitech/3D/HHM1595A1.stp
2.00 x 0.95 x 1.25 mm
