eSpark-Consulting-Group/kurtvogel-athletitech-hw/docs/Client-Files/Original Design/Athletitech/3D/VFQFN48_12X12_QOR.step

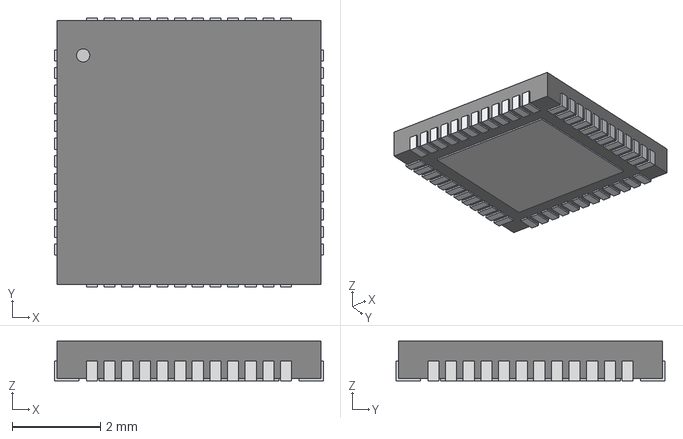
[picture p8: CAD file, 2025-04-07]
docs/Client-Files/Original Design/Athletitech/3D/VFQFN48_12X12_QOR.step
6.10 x 6.10 x 0.903 mm
