eSpark-Consulting-Group/kurtvogel-athletitech-hw/Design Files/AthletiTech/Schematic/AthletiTech_V1.0.pdf

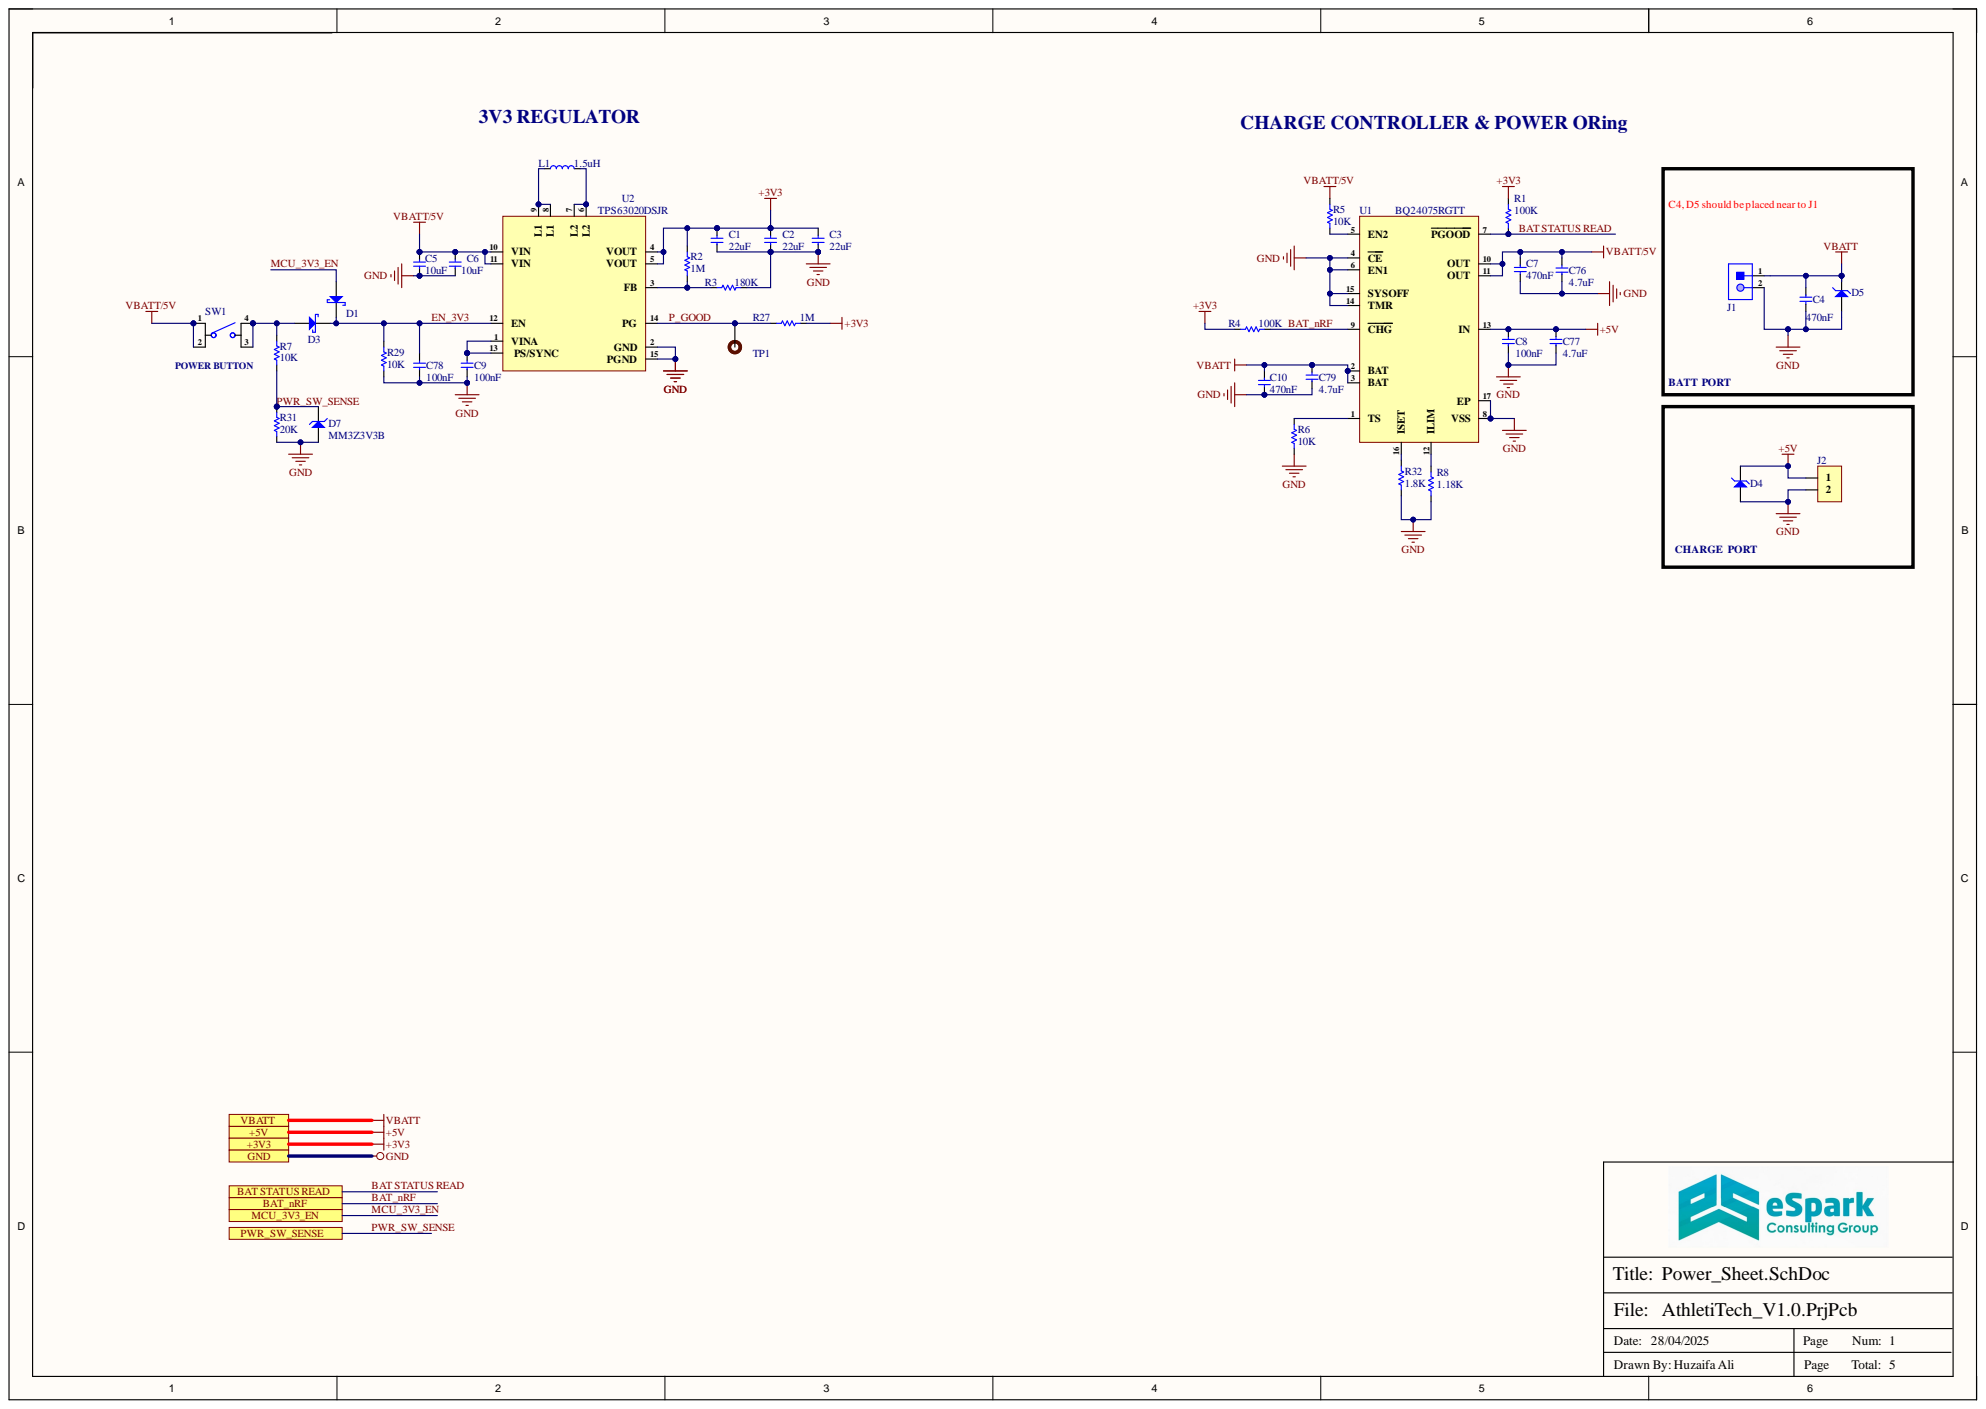
[picture p9: page 1]

CHARGE CONTROLLER & POWER ORing

C4, D5 should be placed near to J1

Date: 28/04/2025 | Page Num: 1

Drawn By: Huzaifa Ali | Total:

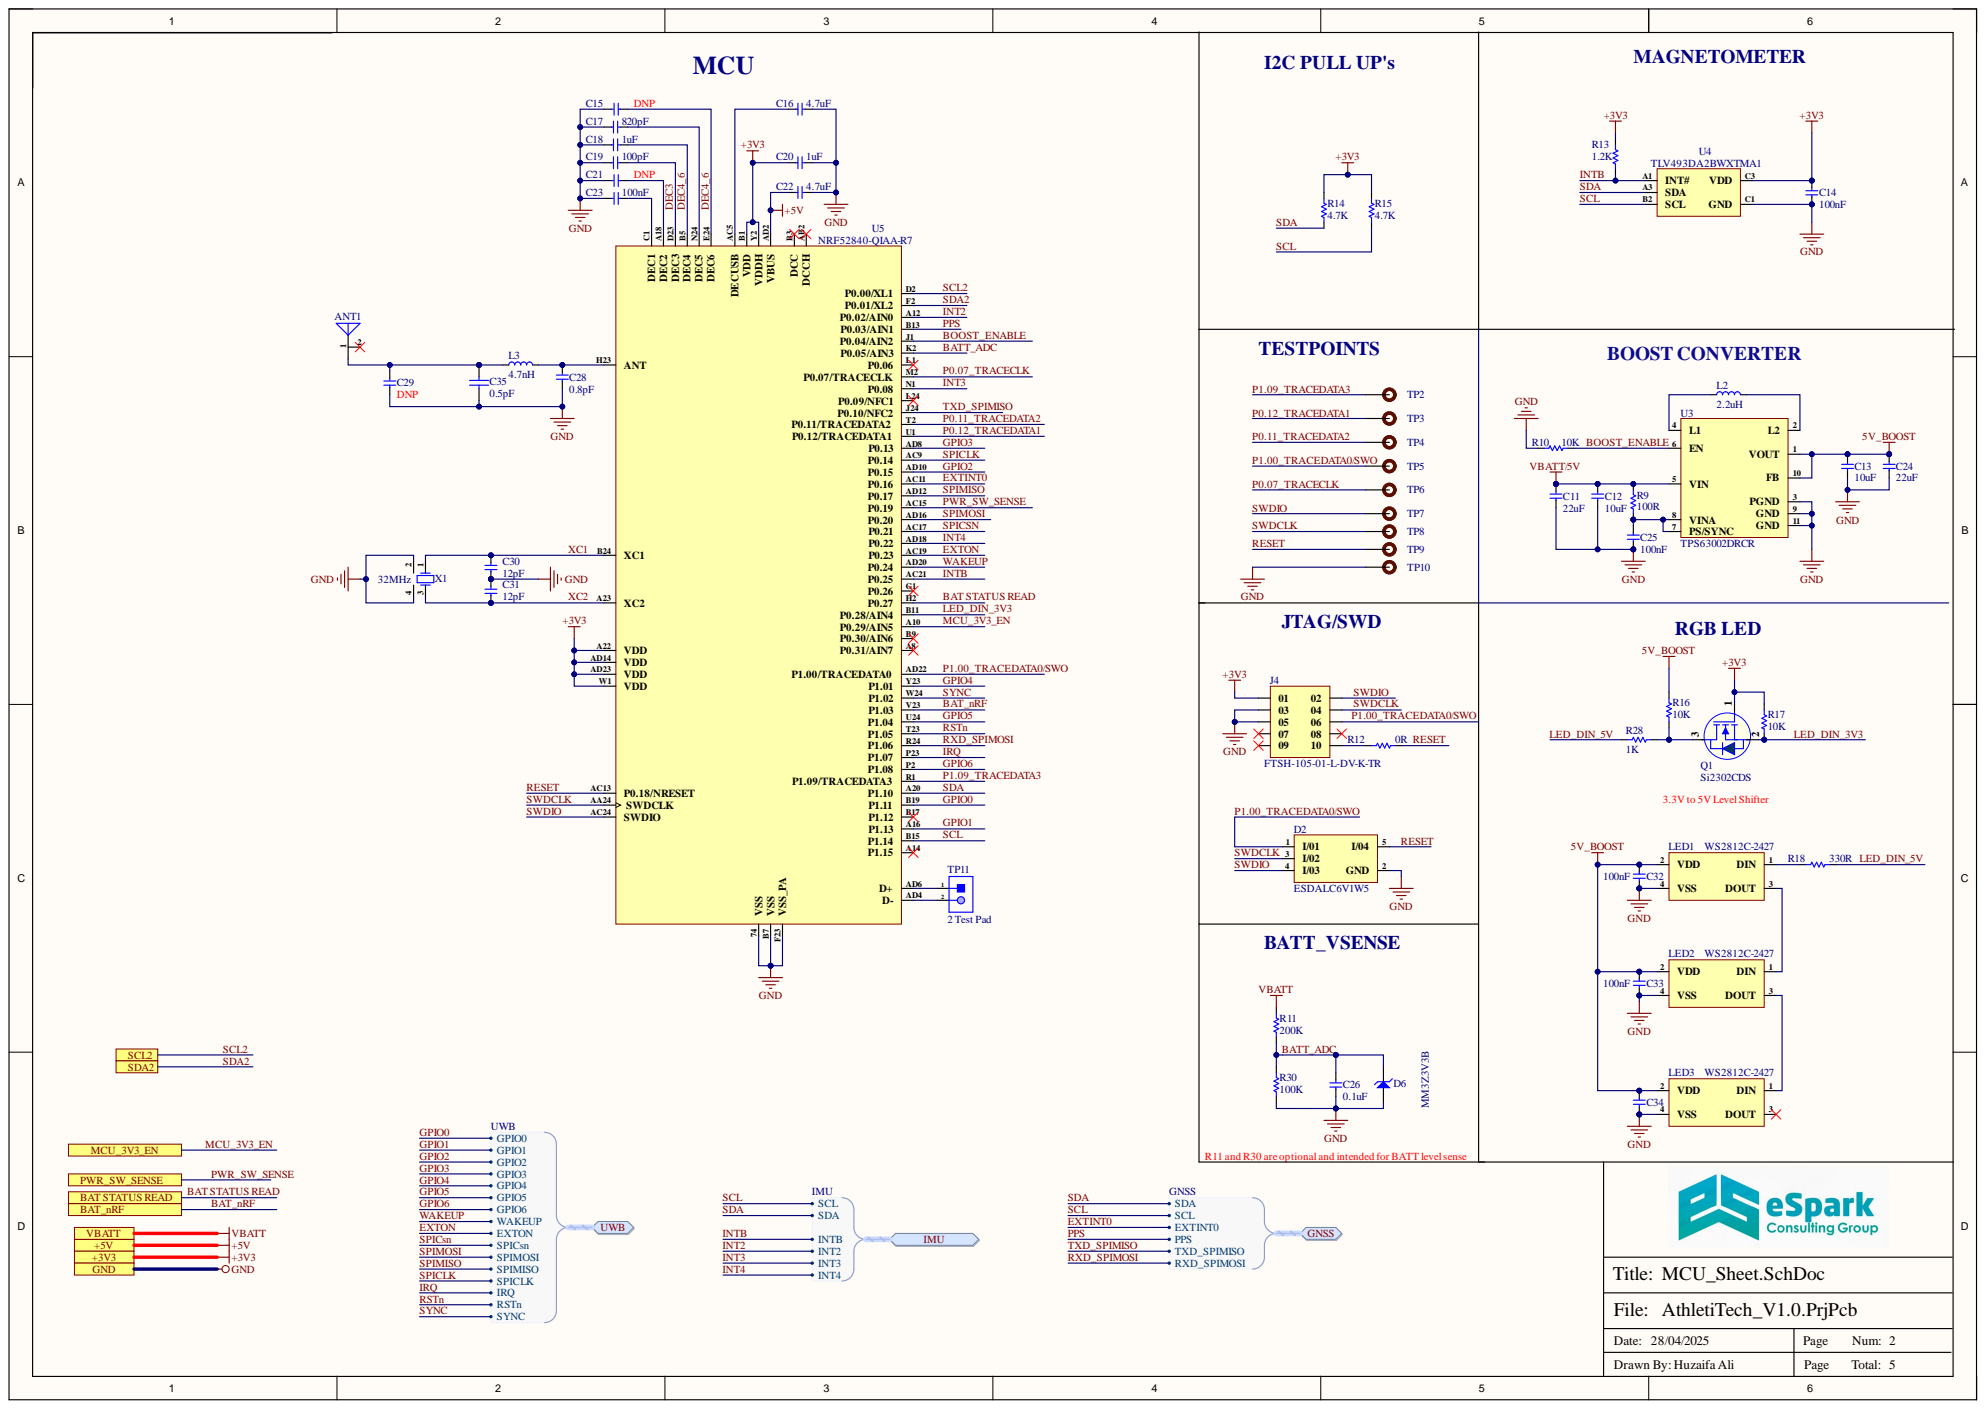
[picture p10: page 2]

Date: 4/2 | Pag e N u m :

D raw n B y : H uzai fa A l i | Pag e To tal :

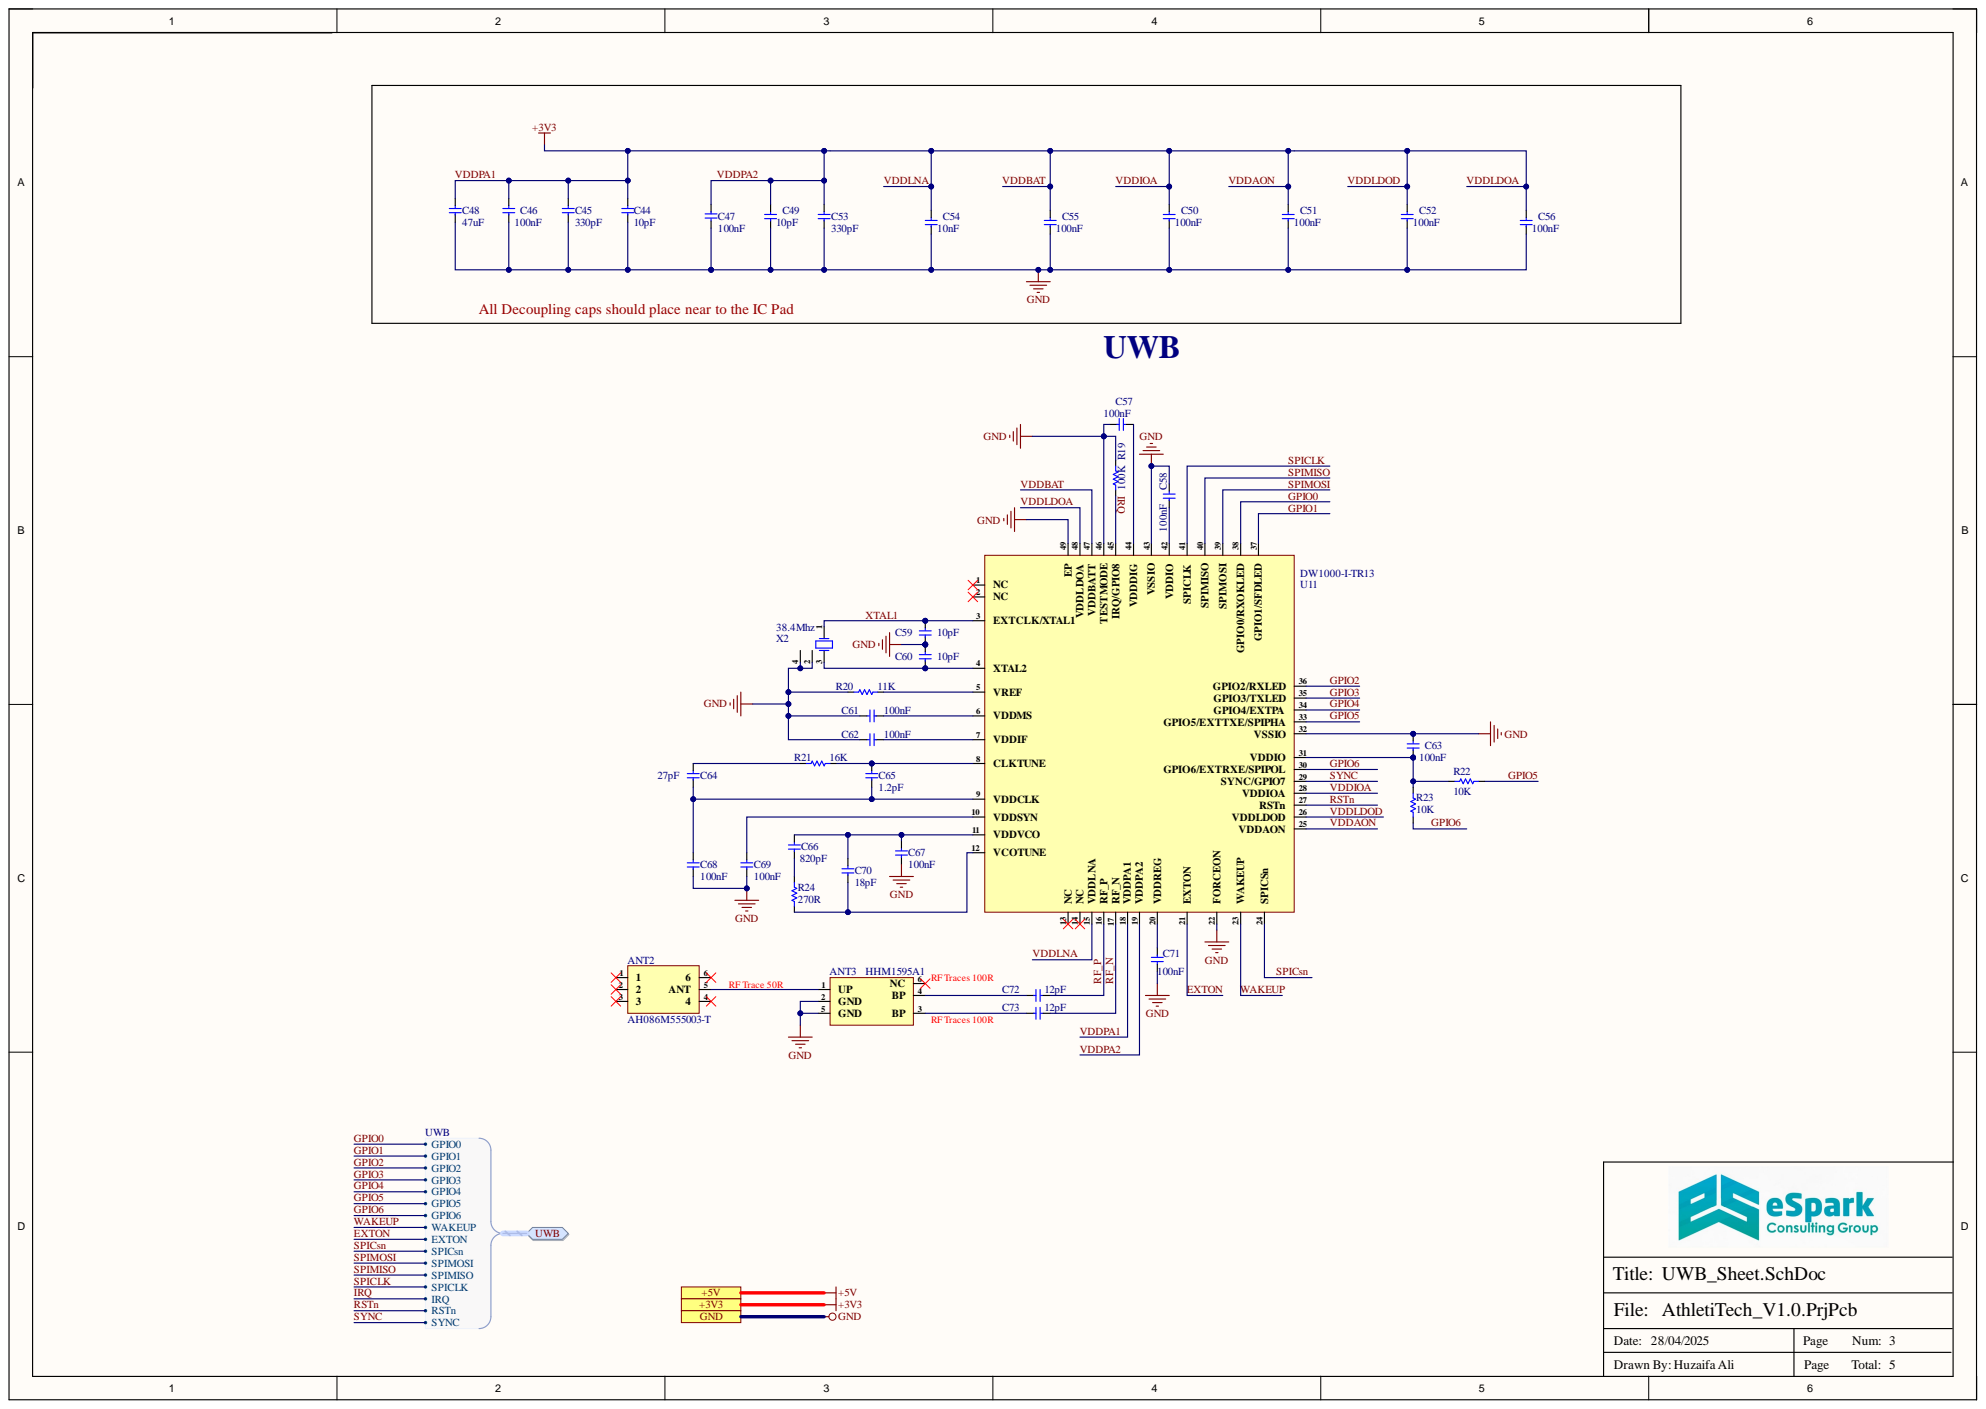
[picture p11: page 3]

All Decoupling caps should place near to the IC Pad

IRQ/GPIO8 45 TESTMODE 46 VDDBATT 47 VDDLDOA 48 EP 49

GND 5

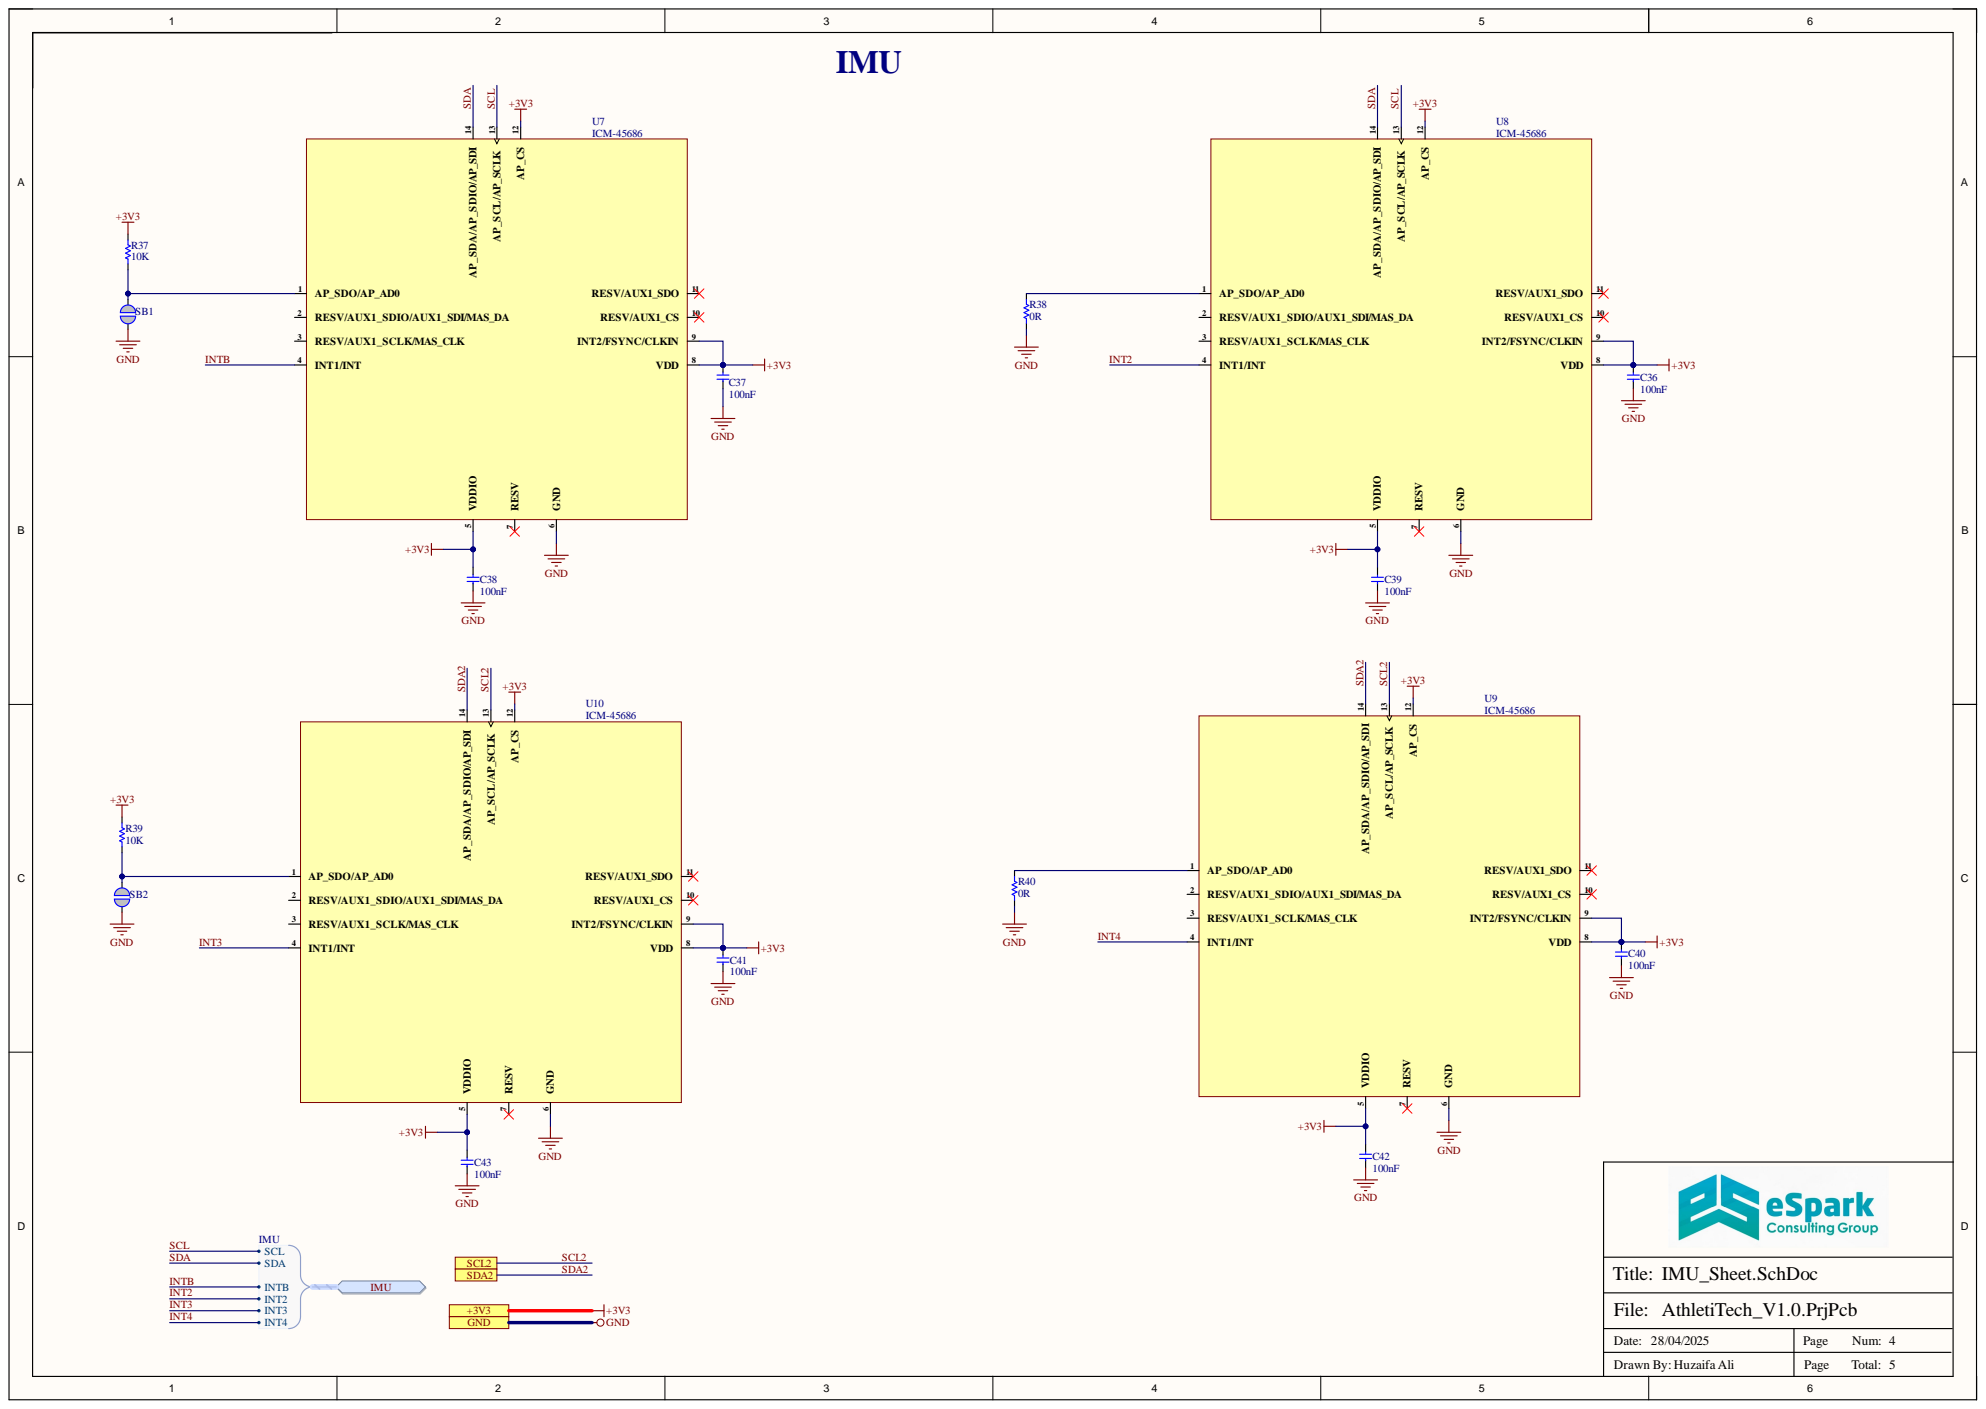
[picture p12: page 4]

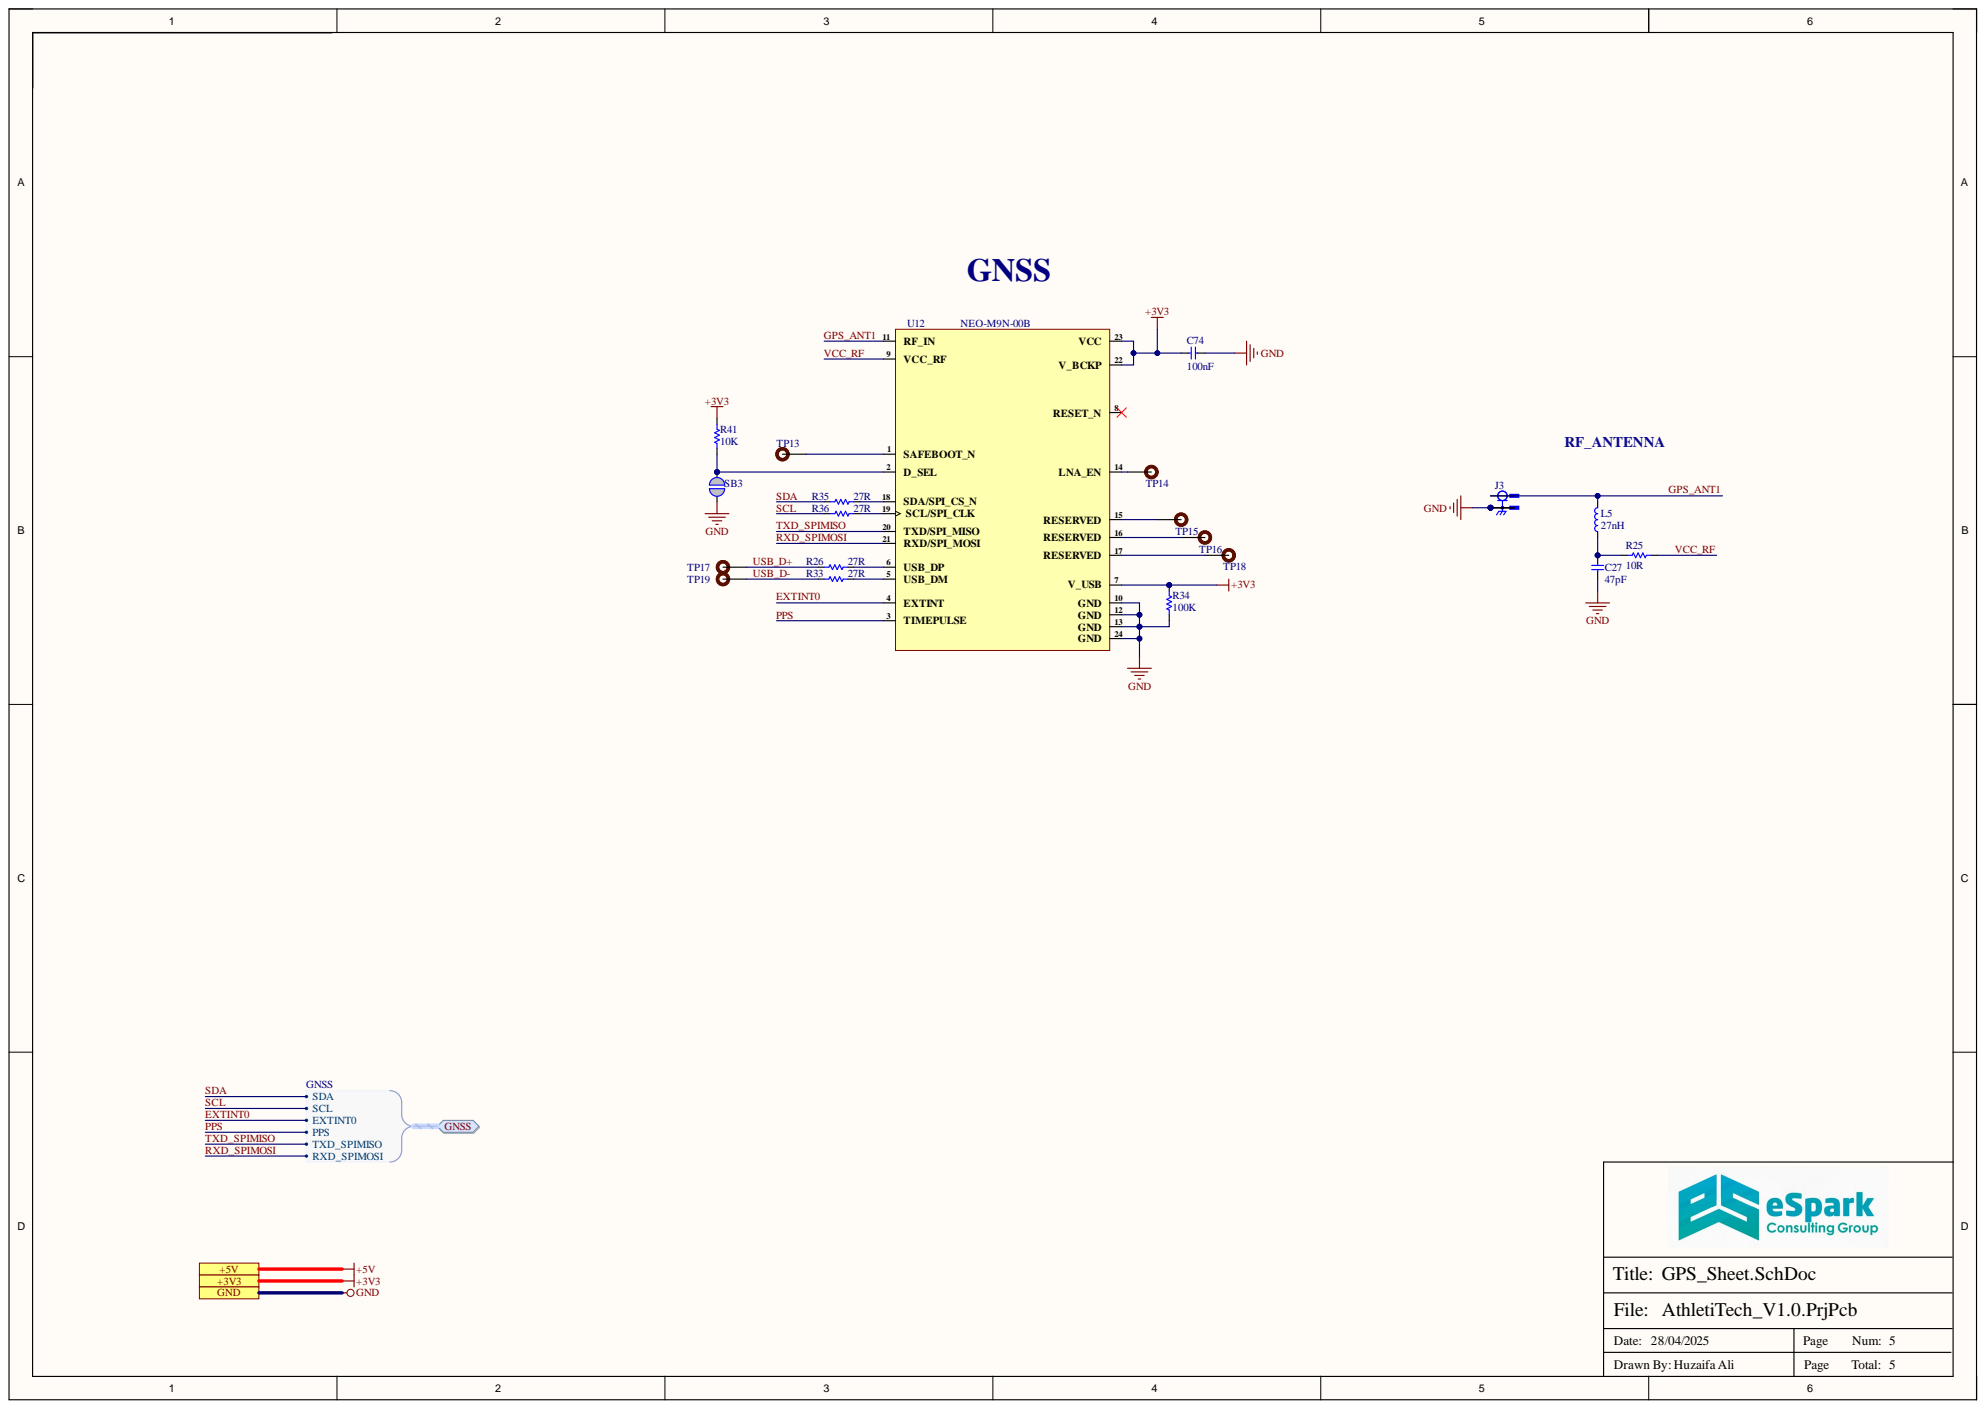
[picture p13: page 5]
