eSpark-Consulting-Group/kurtvogel-athletitech-hw/docs/Client-Files/Original Design/Athletitech/plots/Athletitech__Assembly.pdf

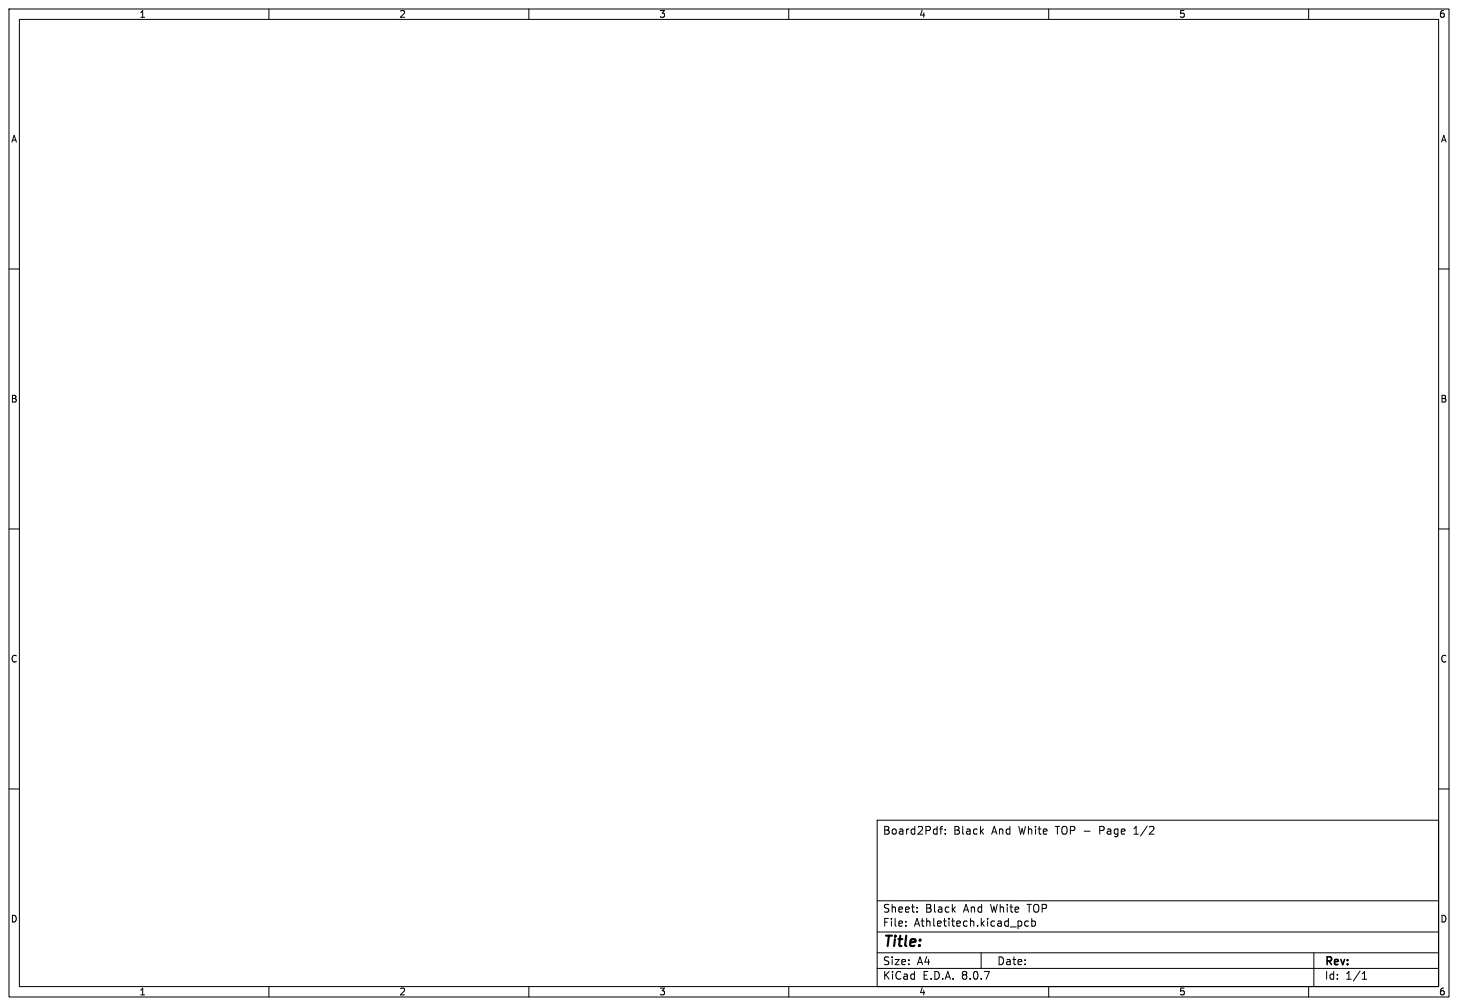
[picture p14: page 1]
D Date: KiCad; E.D.A. 8.0.7 Size: A4; Rev:; Id: 1/1 Title: File: Athletitech.kicad_pcb Sheet: Black; And; White; TOP; Board2Pdf:; Black; TOP -; Page

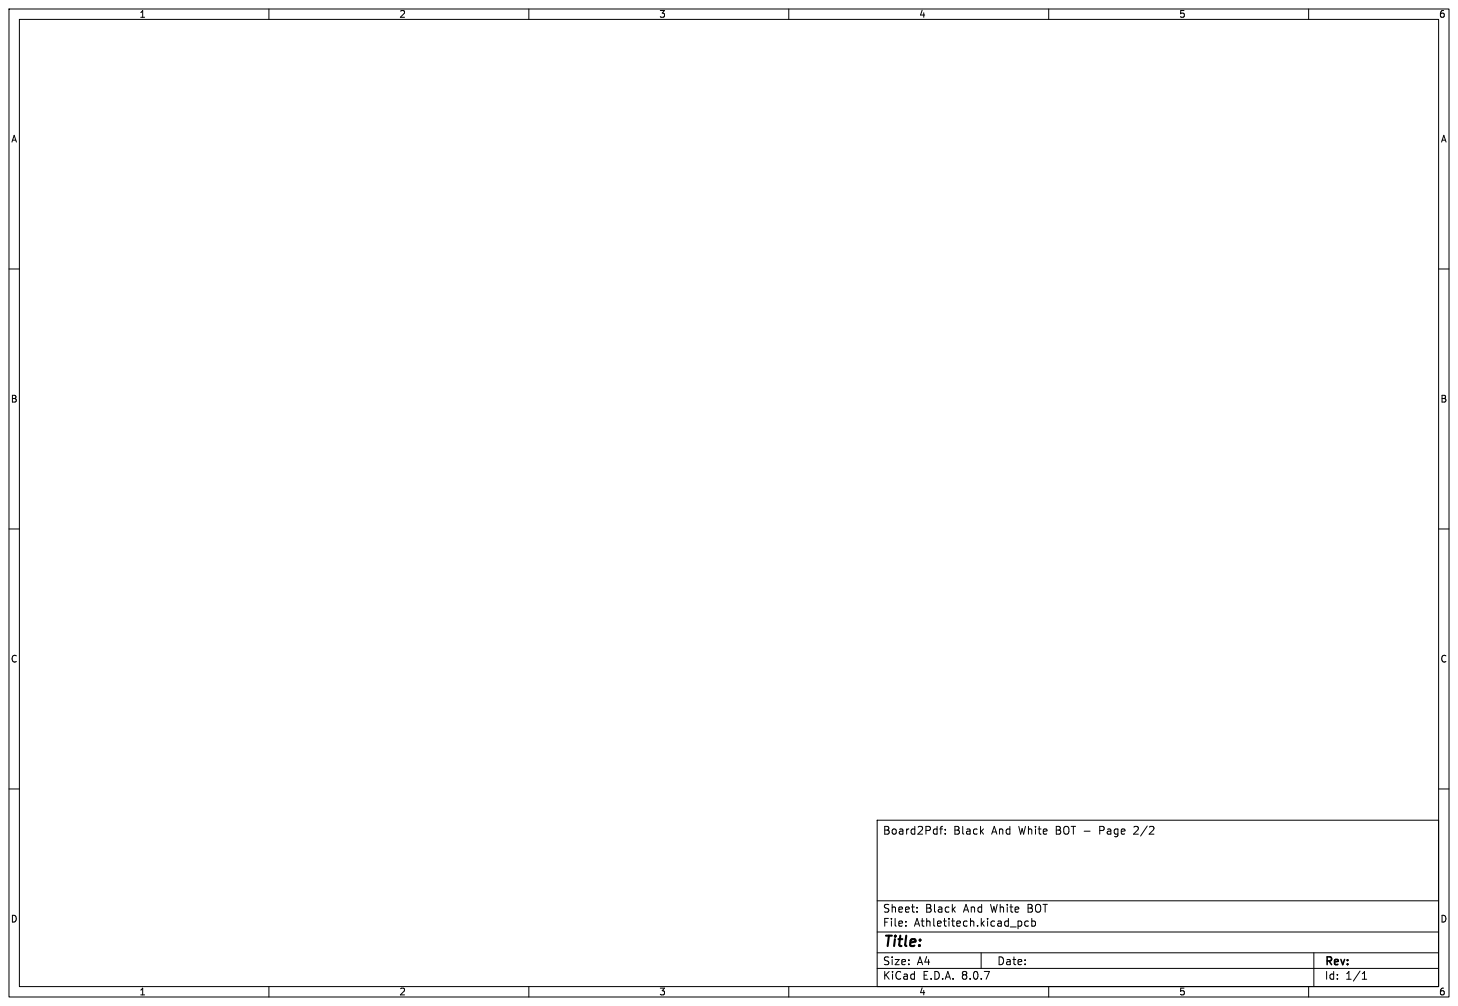
[picture p15: page 2]
D Date: KiCad; E.D.A. 8.0.7 Size: A4; Rev:; Id: 1/1 Title: File: Athletitech.kicad_pcb Sheet: Black; And; White; BOT Board2Pdf:; Black; BOT -; Page 2/2; SMD-LX5050RGB-TR; Jumper_2_Open TestPoint TP9
