eSpark-Consulting-Group/kurtvogel-athletitech-hw/Design Files/AthletiTech/Schematic/AthletiTech.pdf

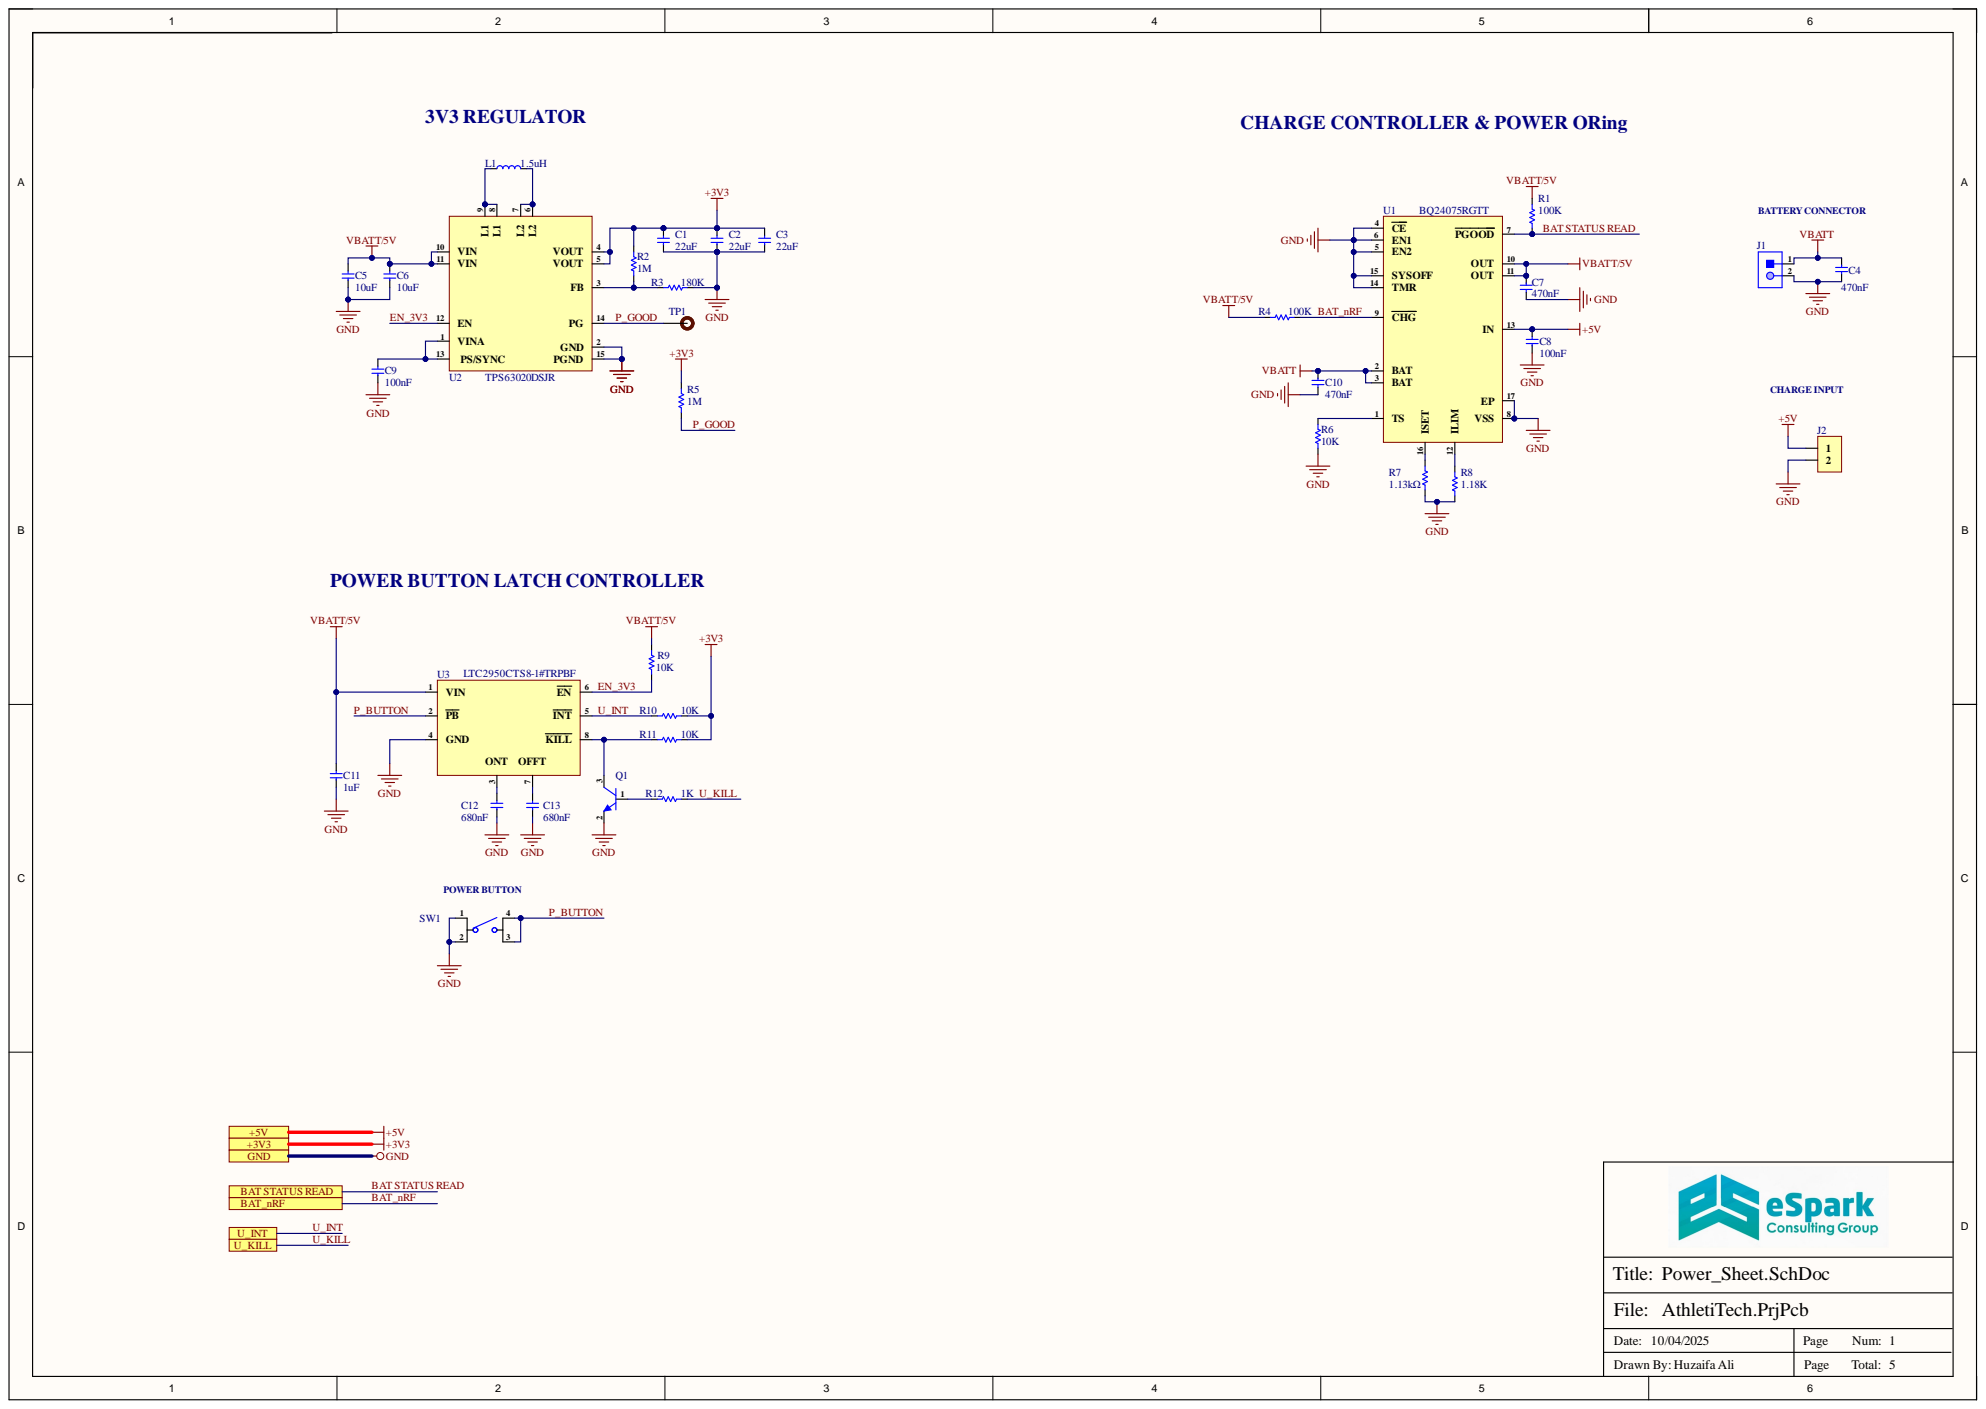
[picture p16: page 1]

CHARGE CONTROLLER & POWER ORing

POWER BUTTON LATCH CONTROLLER

Date: 10/04/2025 | Page Num: 1

Drawn By: Huzaifa Ali | Total:

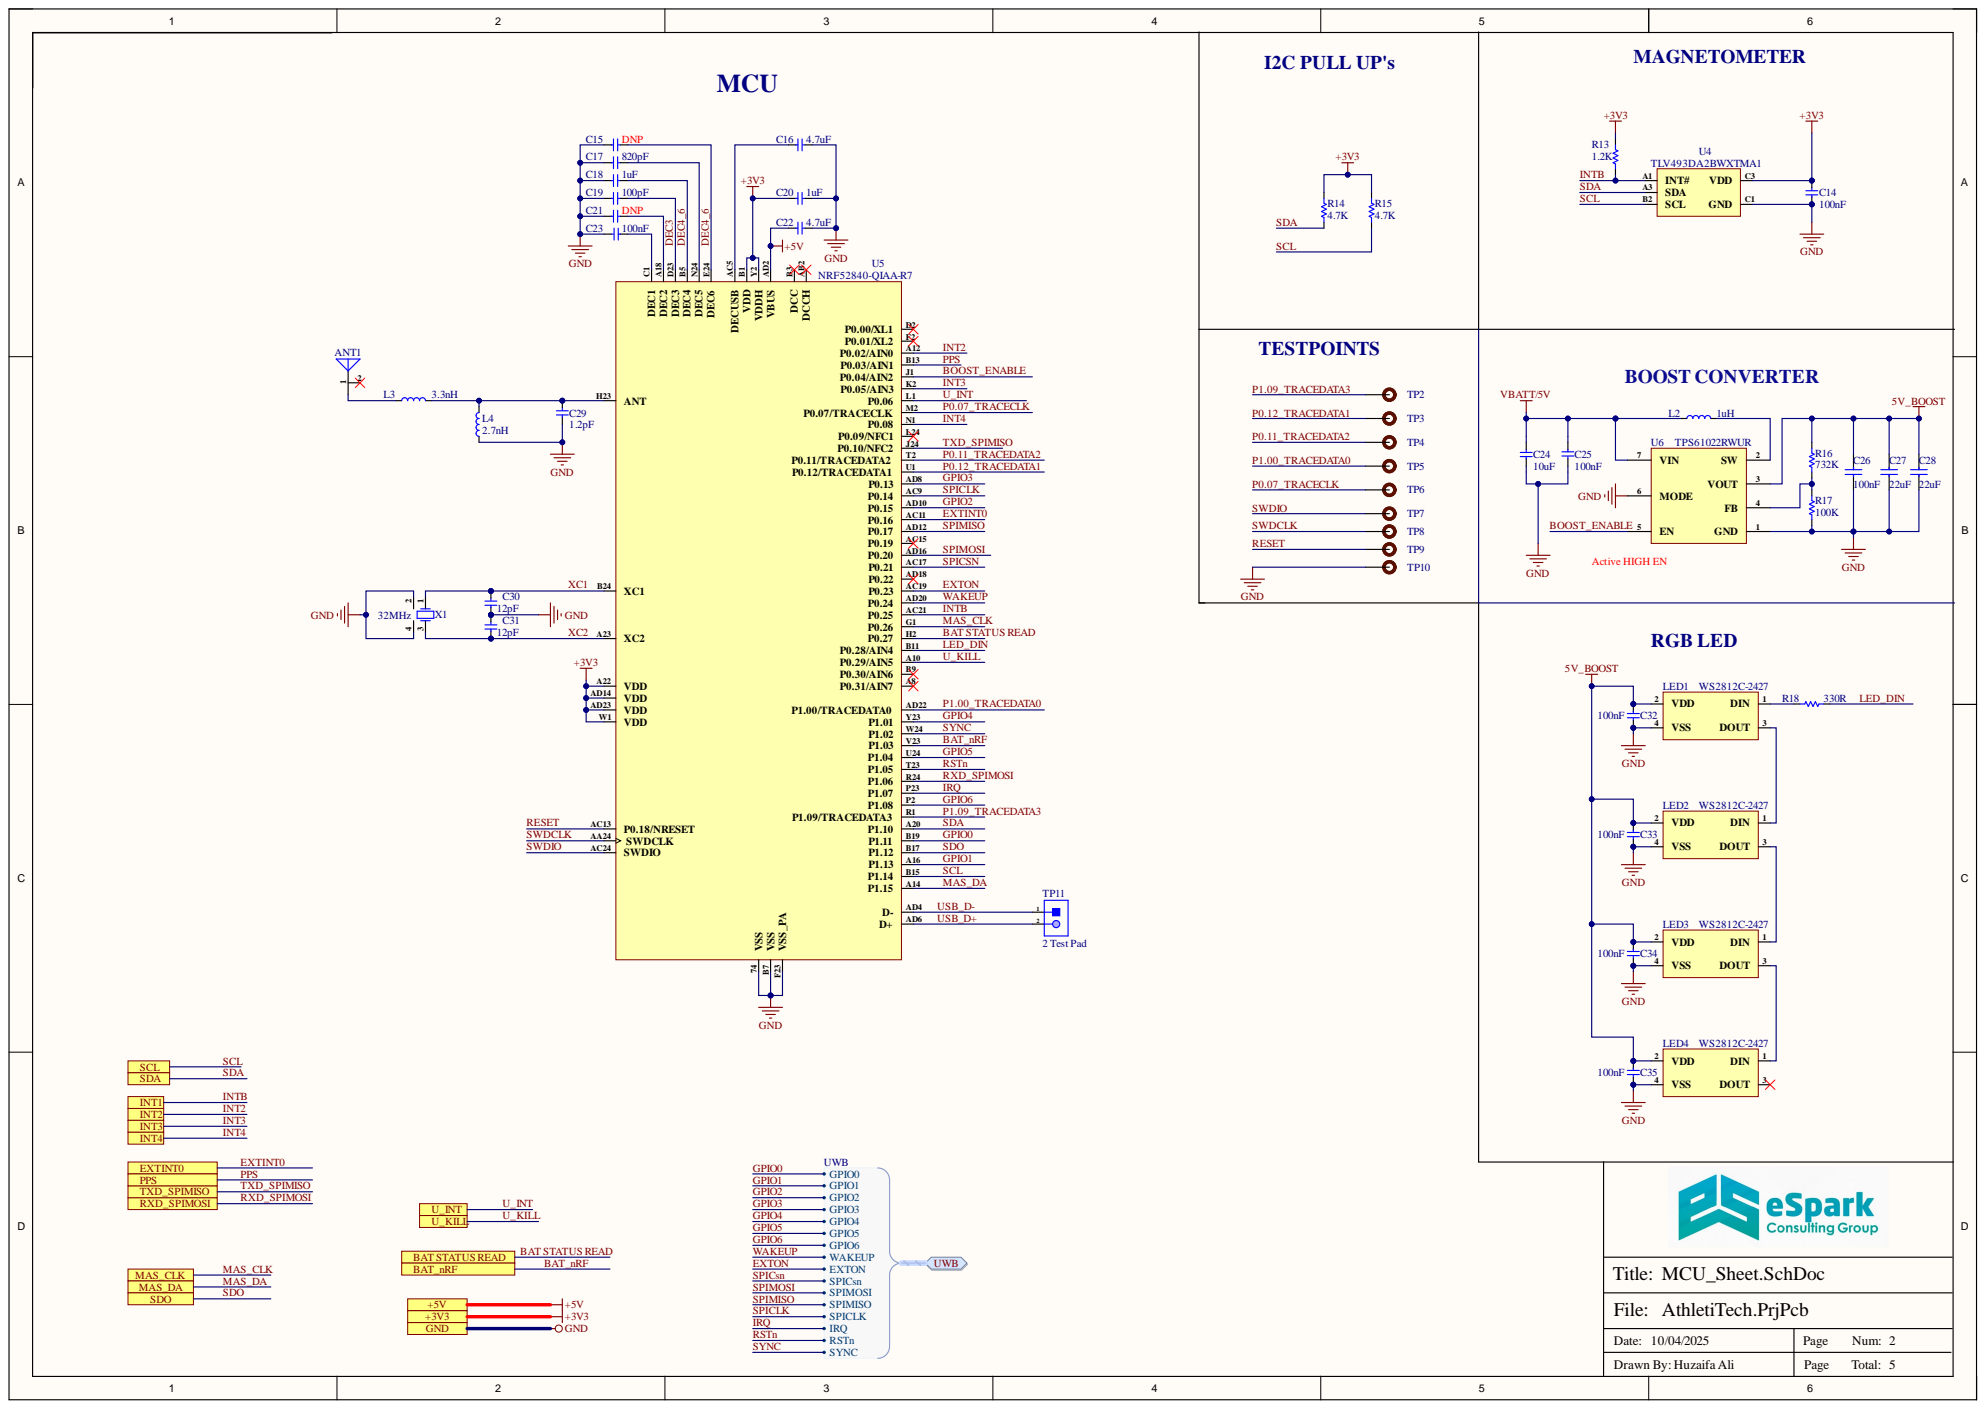
[picture p17: page 2]

Date: 4/2 | Pag e N u m :

D raw n B y : H uzai fa A l i | Pag e To tal :

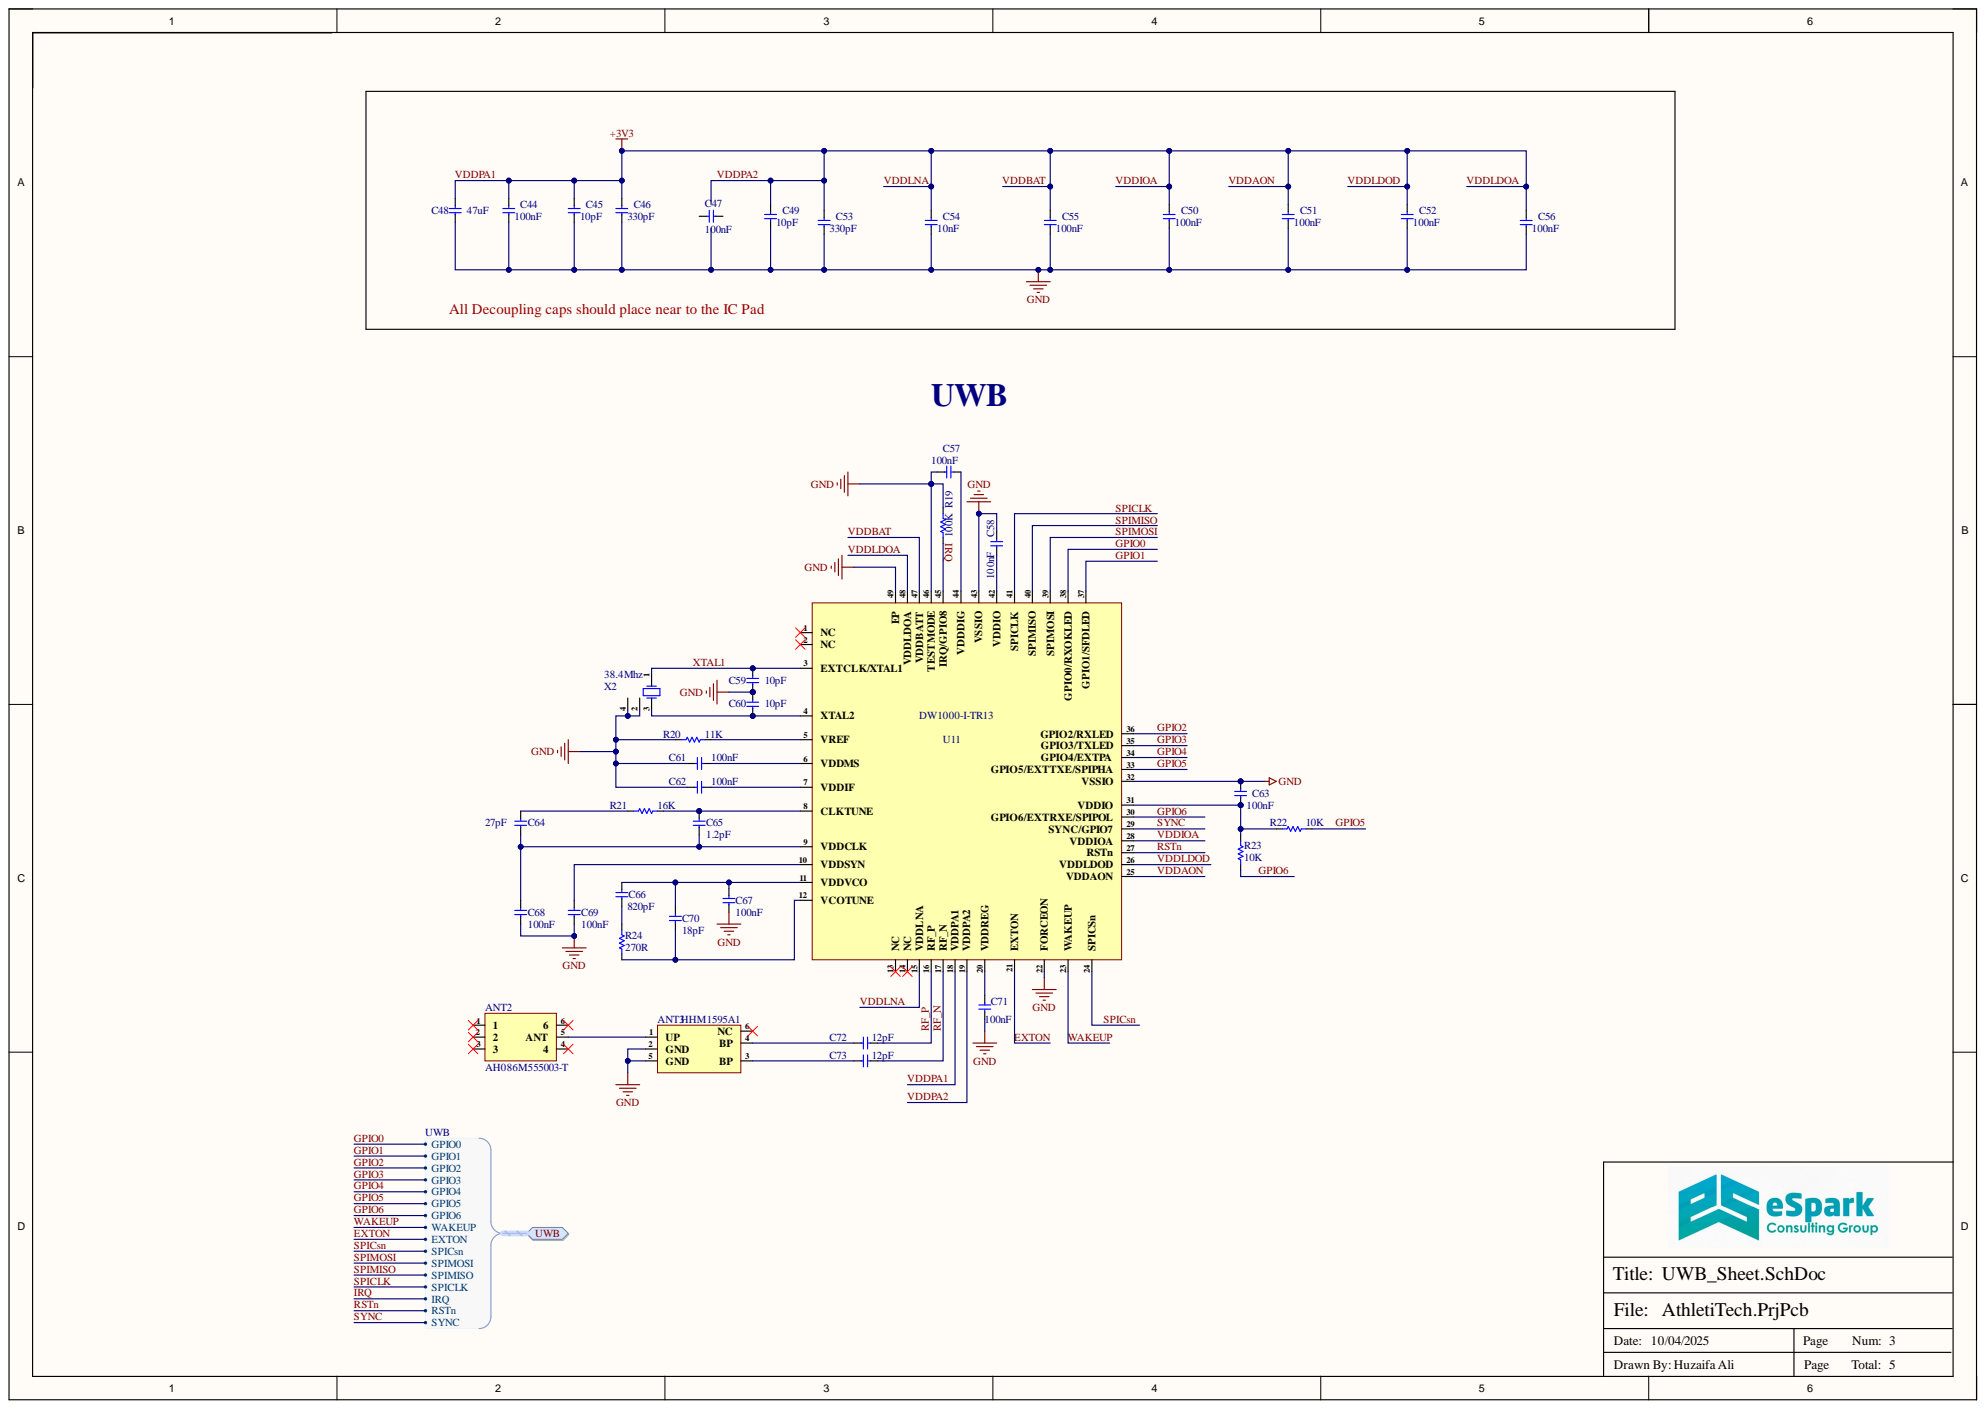
[picture p18: page 3]

All Decoupling caps should place near to the IC Pad

IRQ/GPIO8 45 TESTMODE 46 VDDBATT 47 VDDLDOA 48 EP 49

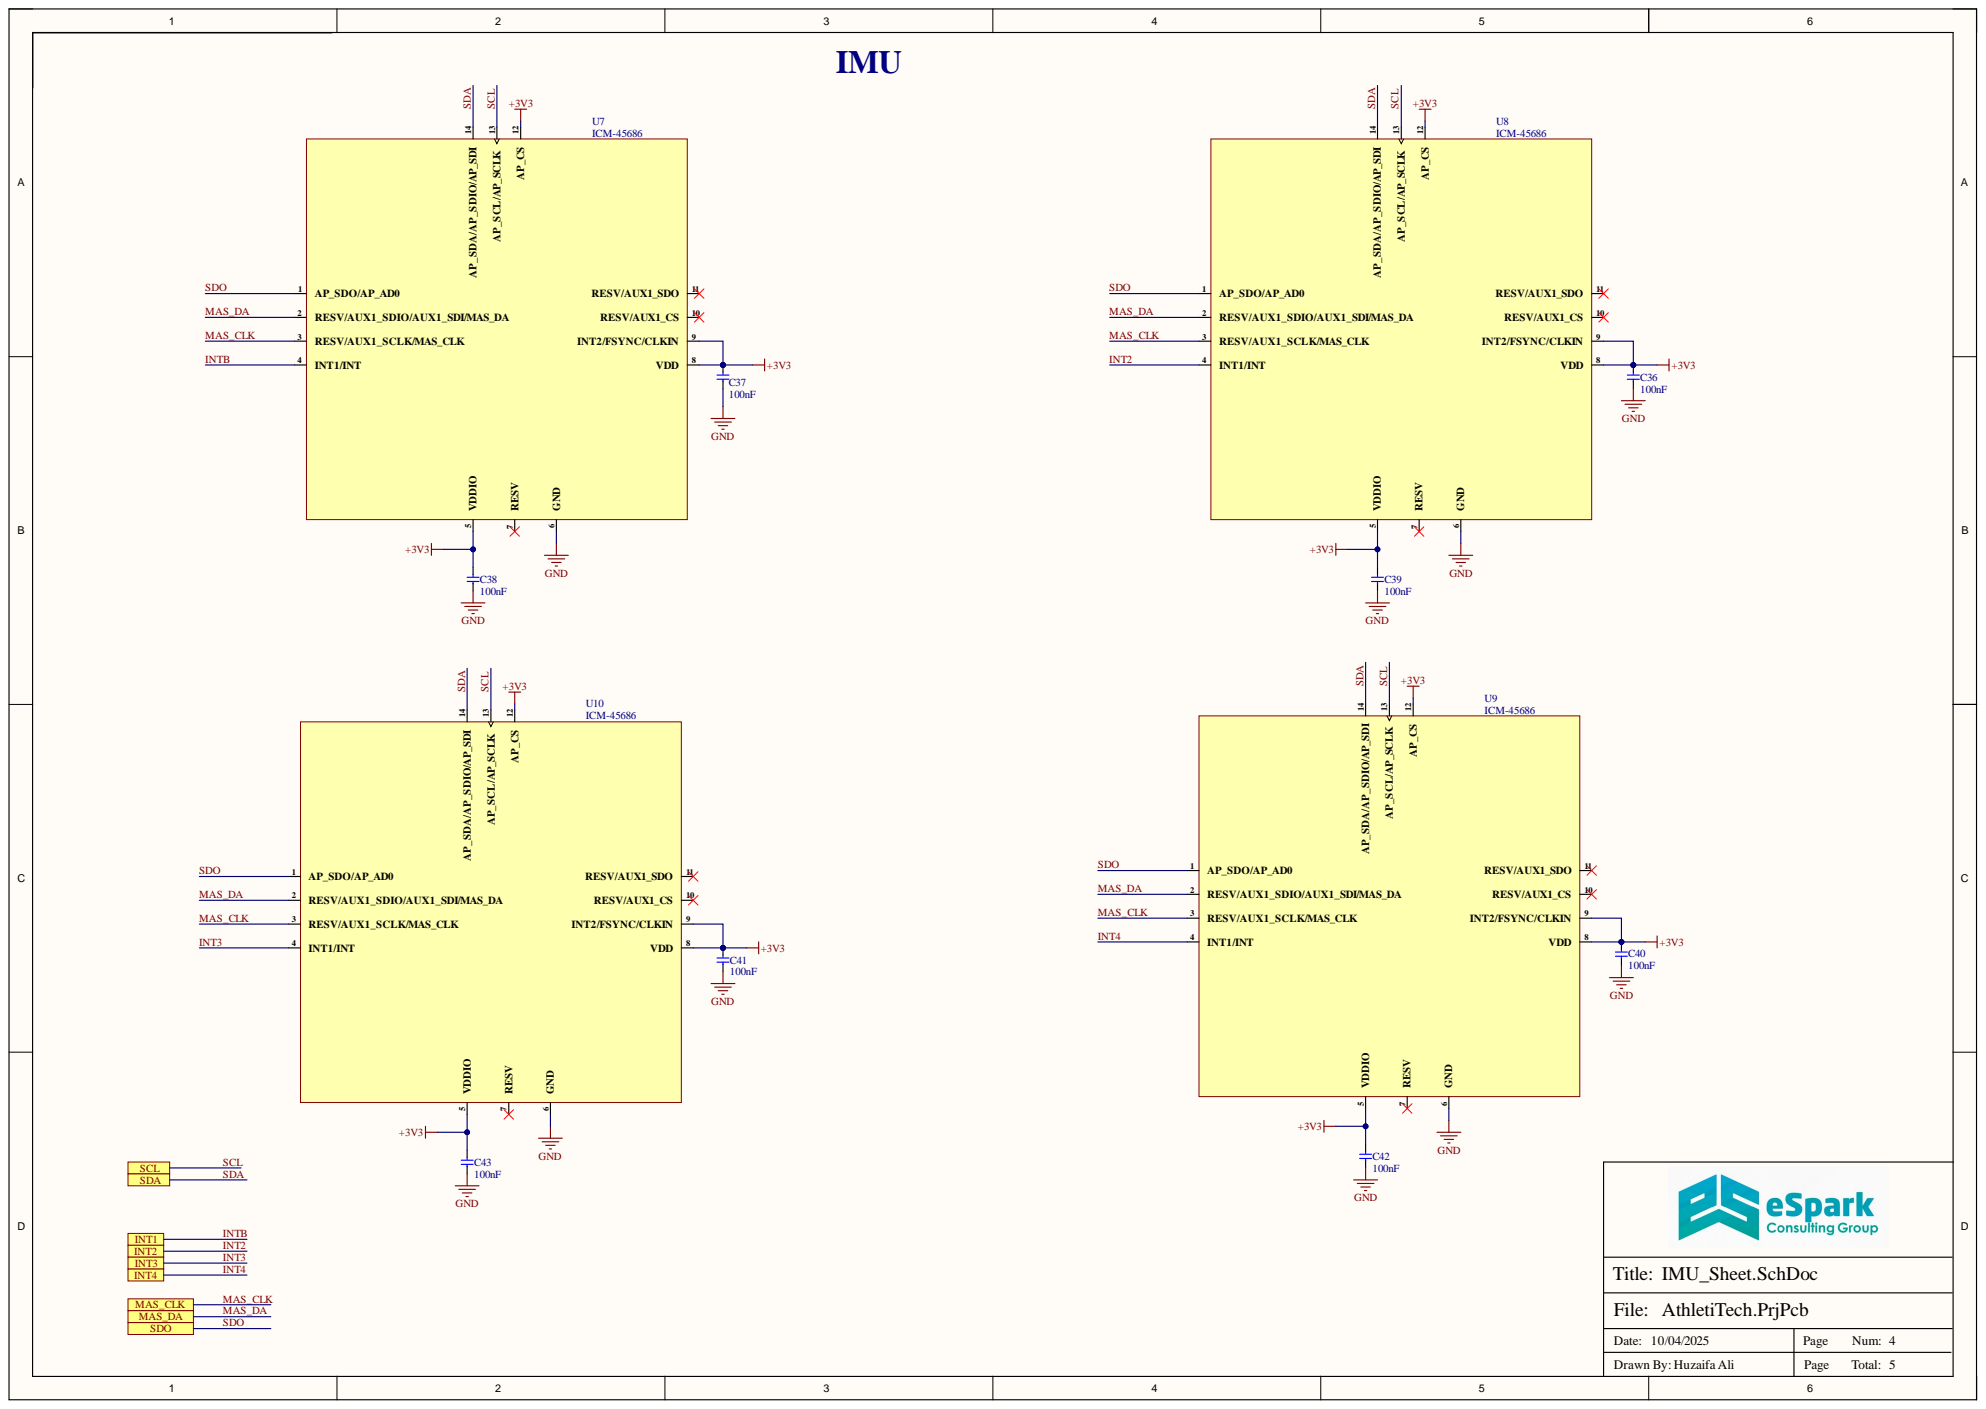
[picture p19: page 4]

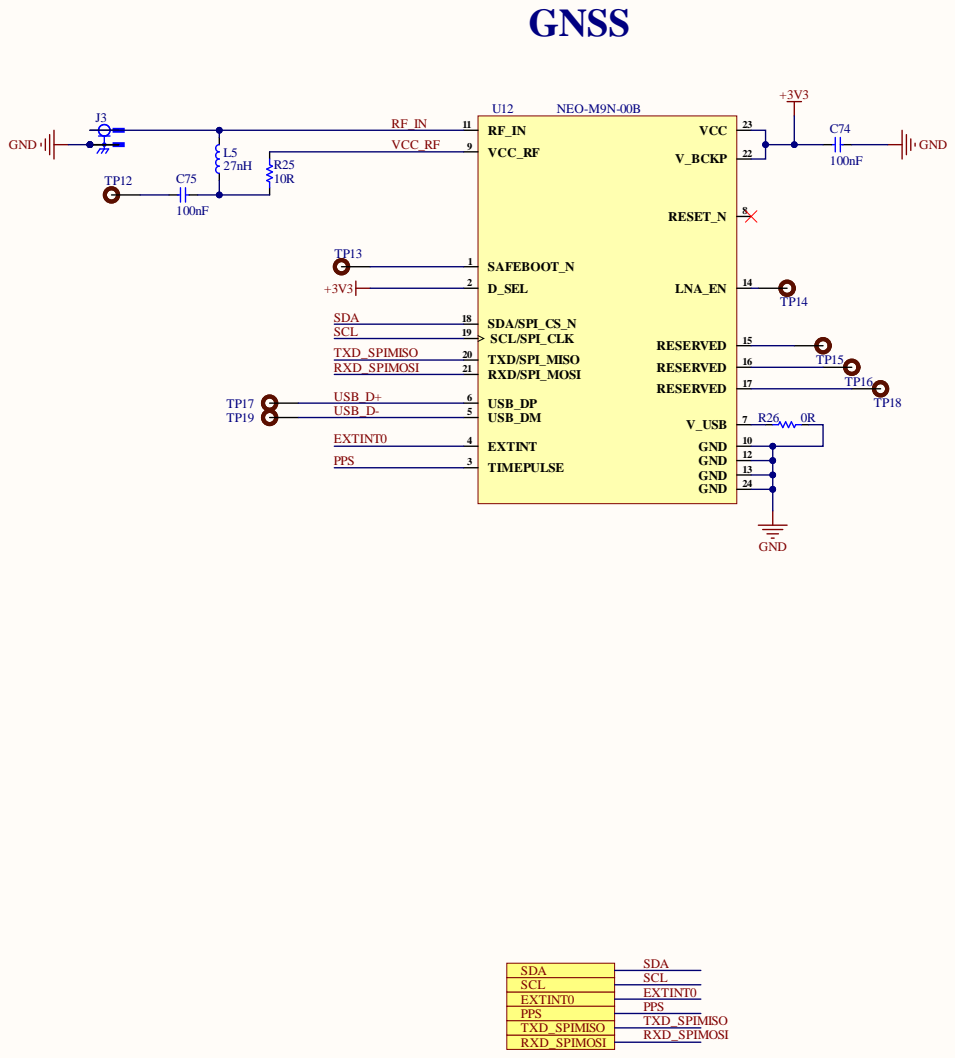
[picture p20: page 5]
