eSpark-Consulting-Group/kurtvogel-athletitech-hw/(list of files, drawings)

Other design files:
Design Files/AthletiTech/AthetiTech_PCB_V1.0.PcbDoc
Design Files/AthletiTech/AthletiTech.PrjPcb
Design Files/AthletiTech/AthletiTech_V1.0.PrjPcb
Design Files/AthletiTech/Charger_Sheet.SchDoc
Design Files/AthletiTech/GPS_Sheet.SchDoc
Design Files/AthletiTech/IMU_Sheet.SchDoc
Design Files/AthletiTech/MAGNETO_Sheet.SchDoc
Design Files/AthletiTech/MCU_Sheet.SchDoc
Design Files/AthletiTech/Power_Sheet.SchDoc
Design Files/AthletiTech/UWB_Sheet.SchDoc
