eSpark-Consulting-Group/kurtvogel-athletitech-hw/docs/Client-Files/Original Design/Athletitech/Athletitech.kicad_pcb

## KiCad design docs/Client-Files/Original Design/Athletitech/Athletitech.kicad_pcb (2025-04-07)

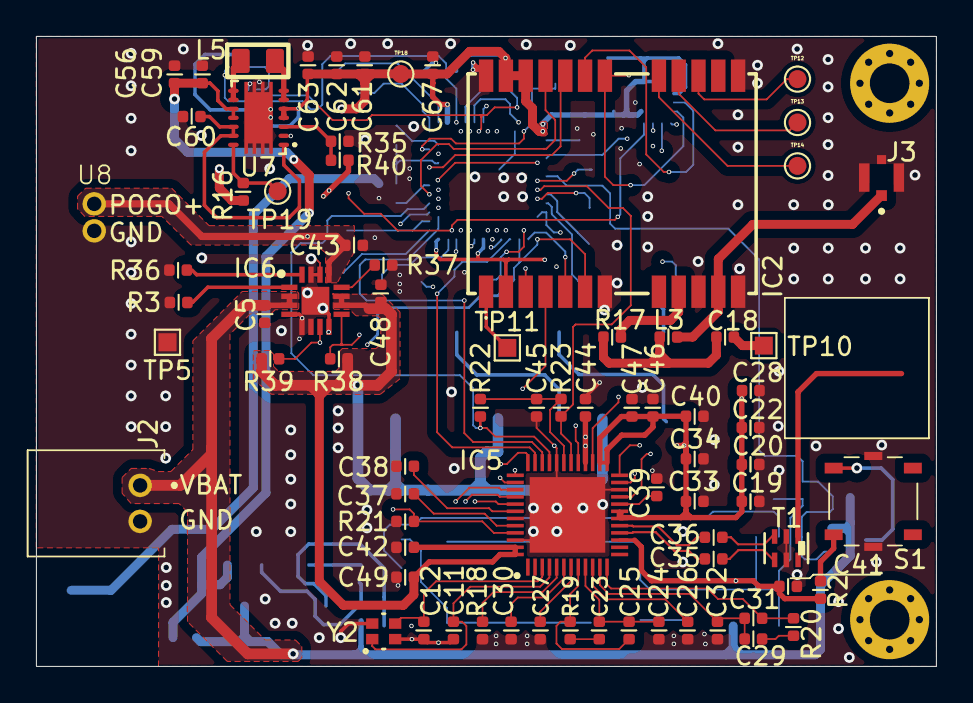
[picture p21: board Athletitech.kicad_pcb from above]

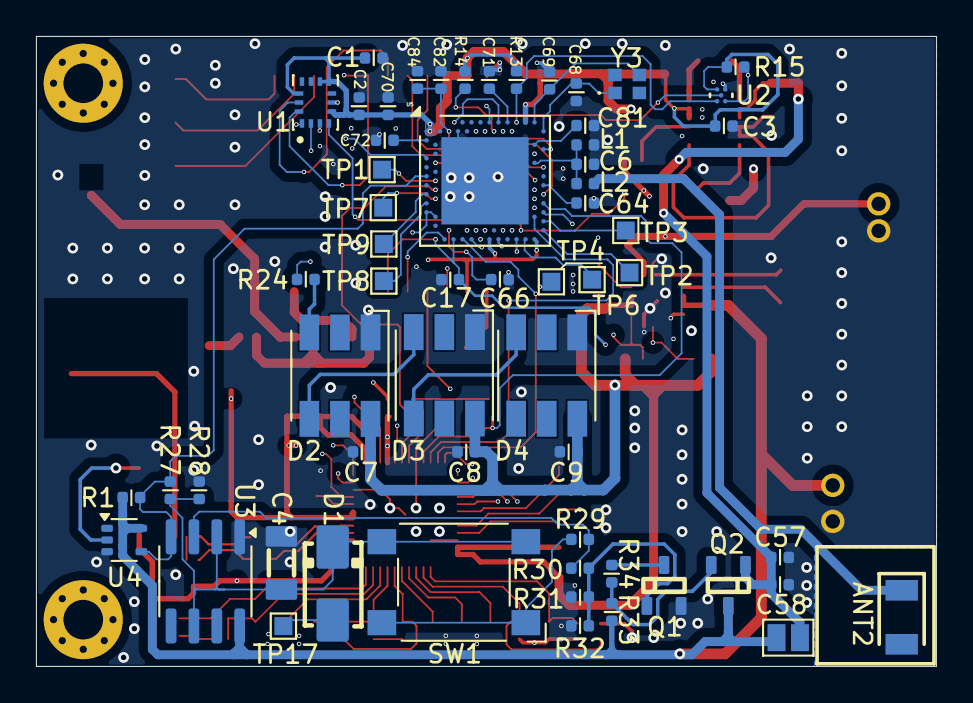
[picture p22: board Athletitech.kicad_pcb from below]

Board: 4 copper layers, 50.0 x 35.0 mm, 139 parts (60 on the bottom side), 102 nets.

Parts:
ANT2: 2450AT18B100E; ANTC3216X140N
C1, C2, C3, C27, C30, C43, C60, C72: 100nF; C_0402_1005Metric
C4: 1uF; C_1206
C5, C48: 470nF; C_0402_1005Metric
C6: 1.2pF; C_0402_1005Metric
C7, C8, C9: 0.1uF; C_0402_1005Metric
C11, C12: 10pF; C_0402_1005Metric
C17, C66: 4.7uF; C_0402_1005Metric
C18, C20, C24, C26, C32, C33, C37, C38, C39, C42, C44, C45, C46, C47, C49, C67: 100nf; C_0402_1005Metric
C19: 47uf; C_0402_1005Metric
C22, C34: 10pf; C_0402_1005Metric
C23: 27pf; C_0402_1005Metric
C25: 1P2; C_0402_1005Metric
C28, C40: 330pf; C_0402_1005Metric
C29: 820pf; C_0402_1005Metric
C31: 18pf; C_0402_1005Metric
C35, C36, C68, C69: 12pf; C_0402_1005Metric
C41: 10000pf; C_0402_1005Metric
C56, C59: 10uF; C_0402_1005Metric
C57: 10uF/25V; C_0402_1005Metric
C58: 0.1uF/25V; C_0402_1005Metric
C61, C62, C63: 22uf; C_0402_1005Metric
C64: 820pF; C_0402_1005Metric
C70, C84: 1uF; C_0402_1005Metric
C71, C82: 5pF; C_0402_1005Metric
C81: 100pf; C_0402_1005Metric
D1: B120-E3/61t; D_SMA
D2, D3, D4: SMD-LX5050RGB-TR; LED_RGB_5050-6
H1, H2: MountingHole_Pad; MountingHole_2.2mm_M2_Pad_Via
IC2: NEO-M9N-00B; NEOM9N00B
IC5: DW1000-I-TR13; QFN40P600X600X90-49N-D
IC6: BQ24075RGTT; QFN50P300X300X80-17N-D
J2: S2B-PH-K-S; S2BPHKS
J3: CONMHF4-SMD-G-T; LINX_CONMHF4-SMD-G-T
JP1: Jumper_2_Open; SolderJumper-2_P1.3mm_Open_Pad1.0x1.5mm
L1: 2.7nH; L_0402_1005Metric
L2: 3.3nH; L_0402_1005Metric
L3: 27nH; C_0402_1005Metric
L5: 1.5uH; L_0805
Q1: FDN337N; SOT23-3
Q2: NTR4101PT1G; SOT23-3
R1: 1k; C_0402_1005Metric
R2: 1K; C_0402_1005Metric
R3: 10kΩ; C_0402_1005Metric
R13, R14: 4k7; C_0402_1005Metric
R15: 1k2; C_0402_1005Metric
R16, R40: 1M; C_0402_1005Metric
R17: 10Ω; C_0402_1005Metric
R18: 11K; C_0402_1005Metric
R19: 16K; C_0402_1005Metric
R20: 270; C_0402_1005Metric
R21, R29, R32, R33: 100K; C_0402_1005Metric
R22, R23, R27, R28, R34: 10K; C_0402_1005Metric
R24: 330R; C_0402_1005Metric
R30: 220; C_0402_1005Metric
R31: DNP; C_0402_1005Metric
R35: 180K; C_0402_1005Metric
R36: 1.13kΩ; C_0402_1005Metric
R37: 1.18kΩ; C_0402_1005Metric
R38, R39: 100kΩ; C_0402_1005Metric
S1: EVQ-PT5A15; EVQPT5A15
SG-WFWLB1: TLV493DA2BWXTMA1; SG-WFWLB-5-2
SW1: SW_Omron_B3FS; SW_SPST_Omron_B3FS-100xP
T1: HHM1595A1; HHM-6_2P0X1P25
TP1, TP2, TP3, TP4, TP5, TP6, TP7, TP8, TP9, TP10, TP11, TP17: TestPoint; TestPoint_Pad_1.0x1.0mm
TP12, TP13, TP14, TP18: TestPoint; TestPoint_Pad_D1.0mm
TP19: Power Good; TestPoint_Pad_D1.0mm
U1: ICM-45686; IC_ICM-45686
U3: TLC555IDR; SOIC-8_3.9x4.9mm_P1.27mm
U4: 74AUP1G06, DNP; SOT-353_SC-70-5
U5: nRF52840; Nordic_AQFN-73-1EP_7x7mm_P0.5mm
U7: TPS63020; QFN14-3X4MM
U8: Mill_Max_854-22-002-20-041101
Y2: 8Y38472012; 8Y384_TXC
Y3: XRCGB32M000F1S1DR0; XRCGB

Connections:
+3.3V: C1.1, C2.1, C3.1, C7.1, C8.1, C9.1, C19.2, C20.1, C22.2, C28.2, C33.1, C34.2, C40.2, C41.2, C42.1, C44.1, C46.1, C47.1, C48.1, C49.1, C61.1, C62.1, C63.1, C67.1, C70.1, D2.6 (VDD), D3.6 (VDD), D4.6 (VDD), IC2.2 (D_SEL), IC2.22 (V_BCKP), IC2.23 (VCC), IC5.15 (VDDLNA), IC5.18 (VDDPA1), IC5.19 (VDDPA2), IC5.25 (VDDAON), IC5.26 (VDDLDOD), IC5.28 (VDDIOA), IC5.47 (VDDBATT), IC5.48 (VDDLDOA), IC6.10 (OUT_1), IC6.11 (OUT_2), R2.1, R13.1, R14.1, R15.1, R16.1, R38.1, R39.1, R40.2, SG-WFWLB1.C3 (VDD), TP18.1, U1.5 (VDDIO), U1.8 (VDD), U1.9 (INT2/FSYNC/CLKIN), U1.12 (AP_CS), U5.A22 (VDD), U5.AD14 (VDD), U5.AD23 (VDD), U5.B1 (VDD), U5.W1 (VDD), U5.Y2 (VDDH), U7.4 (VOUT), U7.5 (VOUT_2)
/BAT_OUT: C56.2, C57.1, C58.1, C59.2, JP1.2 (B), Q2.1 (D), U7.10 (VIN), U7.11 (VIN_2)
/Charger - BQ24075/BAT_STATUS_READ: IC6.7 (~PGOOD), R39.2, U5.H2 (P0.27)
/Charger - BQ24075/BAT_nRF: IC6.9 (~CHG), R38.2, U5.V23 (P1.03)
/GNSS - NEO-M9N-00B/EXTINT0: IC2.4 (EXTINT), U5.AC11 (P0.16)
/GNSS - NEO-M9N-00B/PPS: IC2.3 (TIMEPULSE), U5.B13 (AIN1/P0.03)
/GNSS - NEO-M9N-00B/RXD_SPIMOSI: IC2.21 (RXD_/_SPI_MOSI), U5.R24 (P1.06)
/GNSS - NEO-M9N-00B/TXD_SPIMISO: IC2.20 (TXD_/_SPI_MISO), U5.J24 (NFC2/P0.10)
/GNSS - NEO-M9N-00B/USB_D-: IC2.5 (USB_DM), U5.AD4 (D-)
/IMU - ICM-45686/INT1/INT: R15.2, SG-WFWLB1.A1 (/INT), U1.4 (INT1/INT), U5.AC21 (P0.25)
/IMU - ICM-45686/MAS_CLK: U1.3 (RESV/AUX1_SCLK/MAS_CLK), U5.G1 (P0.26)
/IMU - ICM-45686/MAS_DA: U1.2 (RESV/AUX1_SDIO/AUX1_SDI/MAS_DA), U5.A14 (P1.15)
/IMU - ICM-45686/SDO: U1.1 (AP_SDO/AP_AD0), U5.B17 (P1.12)
/MCU - NRF52840-CKAA-R7/DEC1: C72.1, U5.C1 (DEC1)
/MCU - NRF52840-CKAA-R7/DEC3: C81.2, U5.D23 (DEC3)
/MCU - NRF52840-CKAA-R7/DEC4_6: C82.2, C84.2, U5.B5 (DEC4), U5.E24 (DEC6)
/MCU - NRF52840-CKAA-R7/EXTON: IC5.21 (EXTON), U5.AC19 (P0.23)
/MCU - NRF52840-CKAA-R7/GPIO0: IC5.38 (GPIO0/RXOKLED), U5.B19 (P1.11)
/MCU - NRF52840-CKAA-R7/GPIO1: IC5.37 (GPIO1/SFDLED), U5.A16 (P1.13)
/MCU - NRF52840-CKAA-R7/GPIO2: IC5.36 (GPIO2/RXLED), U5.AD10 (P0.15)
/MCU - NRF52840-CKAA-R7/GPIO3: IC5.35 (GPIO3/TXLED), U5.AD8 (P0.13)
/MCU - NRF52840-CKAA-R7/GPIO4: IC5.34 (GPIO4/EXTPA), U5.Y23 (P1.01)
/MCU - NRF52840-CKAA-R7/IRQ: IC5.45 (IRQ/GPIO8), R21.1, U5.P23 (P1.07)
/MCU - NRF52840-CKAA-R7/LED_DIN: R24.1, U5.B11 (AIN4/P0.28)
/MCU - NRF52840-CKAA-R7/P0.07_TRACECLK: TP1.1, U5.M2 (TRACECLK/P0.07)
/MCU - NRF52840-CKAA-R7/P0.11_TRACEDATA2: TP7.1, U5.T2 (TRACEDATA2/P0.11)
/MCU - NRF52840-CKAA-R7/P0.12_TRACEDATA1: TP8.1, U5.U1 (TRACEDATA1/P0.12)
/MCU - NRF52840-CKAA-R7/P1.00_TRACEDATA0: TP6.1, U5.AD22 (TRACEDATA0/P1.00)
/MCU - NRF52840-CKAA-R7/P1.09_TRACEDATA3: TP9.1, U5.R1 (TRACEDATA3/P1.09)
/MCU - NRF52840-CKAA-R7/RESET: TP4.1, U5.AC13 (P0.18/~RESET)
/MCU - NRF52840-CKAA-R7/RSTn: IC5.27 (RSTN), U5.T23 (P1.05)
/MCU - NRF52840-CKAA-R7/SPICLK: IC5.41 (SPICLK), U5.AC9 (P0.14)
/MCU - NRF52840-CKAA-R7/SPICSN: IC5.24 (SPICSN), U5.AC17 (P0.21)
/MCU - NRF52840-CKAA-R7/SPIMISO: IC5.40 (SPIMISO), U5.AD12 (P0.17)
/MCU - NRF52840-CKAA-R7/SPIMOSI: IC5.39 (SPIMOSI), U5.AD16 (P0.20)
/MCU - NRF52840-CKAA-R7/SWDCLK: TP3.1, U5.AA24 (SWDCLK)
/MCU - NRF52840-CKAA-R7/SWDIO: TP2.1, U5.AC24 (SWDIO)
/MCU - NRF52840-CKAA-R7/SYNC: IC5.29 (SYNC/GPIO7), U5.W24 (P1.02)
/MCU - NRF52840-CKAA-R7/WAKEUP: IC5.23 (WAKEUP), U5.AD20 (P0.24)
/MCU - NRF52840-CKAA-R7/XC1: C68.1, U5.B24 (XC1), Y3.1 (XTAL_1)
/MCU - NRF52840-CKAA-R7/XC2: C69.1, U5.A23 (XC2), Y3.3 (XTAL_2)
/POGO+: C43.1, C66.1, IC2.6 (USB_DP), IC6.13 (IN), U5.AD2 (VBUS), U5.AD6 (D+), U8.1
/SCL: IC2.19 (SCL_/_SPI_SLK_), R14.2, SG-WFWLB1.B2 (SCL), U1.13 (AP_SCL/AP_SCLK), U5.B15 (P1.14)
/SDA: IC2.18 (SDA_/_SPI_CS_N), R13.2, SG-WFWLB1.A3 (SDA), U1.14 (AP_SDA/AP_SDIO/AP_SDI), U5.A20 (P1.10)
/UWB - DW1000-I-TR13/GPIO5: IC5.33 (GPIO5/EXTTXE/SPIPOL), R22.2, U5.U24 (P1.04)
/UWB - DW1000-I-TR13/GPIO6: IC5.30 (GPIO6/EXTRXE/SPIPHA), R23.2, U5.P2 (P1.08)
/UWB - DW1000-I-TR13/N: C36.1, T1.3 (BALANCED_PORT_1)
/UWB - DW1000-I-TR13/P: C35.1, T1.4 (BALANCED_PORT_2)
/UWB - DW1000-I-TR13/RF_N: C36.2, IC5.17 (RF_N)
/UWB - DW1000-I-TR13/RF_P: C35.2, IC5.16 (RF_P)
/UWB - DW1000-I-TR13/XTAL1: C12.2, IC5.3 (EXTCLK/XTAL_1), Y2.3 (CRYSTAL_2)
/VBAT: C5.1, IC6.2 (BAT_1), IC6.3 (BAT_2), J2.1, JP1.1 (A), Q2.3 (S), R1.2, R33.2, U3.8 (VCC), U4.5 (VCC)
GND: C1.2, C2.2, C3.2, C4.2, C5.2, C6.1, C7.2, C8.2, C9.2, C11.2, C12.1, C17.2, C19.1, C20.2, C22.1, C24.2, C26.1, C27.2, C28.1, C30.2, C32.2, C33.2, C34.1, C37.2, C38.2, C39.2, C40.1, C41.1, C42.2, C43.2, C44.2, C45.2, C46.2, C47.2, C48.2, C49.2, C56.1, C57.2, C58.2, C59.1, C60.1, C61.2, C62.2, C63.2, C64.1, C66.2, C67.2, C68.2, C69.2, C70.2, C71.2, C72.2, C81.1, C82.1, C84.1, D2.1 (VSS), D3.1 (VSS), D4.1 (VSS), IC2.7 (V_USB), IC2.10 (GND_1), IC2.12 (GND_2), IC2.13 (GND_3), IC2.24 (GND_4), IC5.22 (FORCEON), IC5.32 (VSSIO_1), IC5.43 (VSSIO_2), IC5.46 (TESTMODE), IC5.49 (GND), IC6.4 (~CE), IC6.5 (EN2), IC6.6 (EN1), IC6.8 (VSS), IC6.14 (TMR), IC6.15 (SYSOFF), IC6.17 (VSS_THERMAL_PAD), J2.2, J3.S1, J3.S2, J3.S3, L1.1, Q1.2 (S), R3.1, R18.2, R21.2, R28.2, R31.2, R32.1, R35.1, R36.2, R37.1, S1.MP1, S1.MP2, SG-WFWLB1.C1 (GND), T1.2 (GND_1), T1.5 (GND_2), TP5.1, U1.6 (GND), U3.1 (GND), U4.3 (GND), U5.B7 (VSS), U5.EP (VSS), U5.F23 (VSS_PA), U7.2 (GND), U7.15 (PGND), U7.16 (PGND1), U7.17 (PGND2), U7.18 (PGND3), U7.19 (PGND4), U7.20 (PGND5), U7.21 (PGND6), U7.22 (PGND7), U7.23 (PGND8), U8.2, Y2.2 (GND_1), Y2.4 (GND_2)
MCU_BT_OFF_1: R1.1, R27.1, U3.4 (R), U4.4, U5.L1 (P0.06)
unnamed: ANT2.1 (FEED), L2.1
unnamed: C18.1, TP10.1
unnamed: C18.2, L3.1, R17.2
unnamed: C23.1, R19.2
unnamed: C29.2, R20.1
unnamed: C4.1, D1.2 (A), R27.2, R28.1, SW1.2, U3.2 (TR), U3.6 (THR)
unnamed: D1.1 (K), TP17.1
unnamed: D2.3 (DIN), R24.2
unnamed: D2.4 (DOUT), D3.3 (DIN)
unnamed: D3.4 (DOUT), D4.3 (DIN)
unnamed: IC2.15 (RESERVED_1), TP12.1
unnamed: IC2.16 (RESERVED_2), TP13.1
unnamed: IC2.17 (RESERVED_3), TP14.1
unnamed: IC2.11 (RF_IN), J3.1, L3.2
unnamed: IC2.1 (SAFEBOOT_N), TP11.1
unnamed: IC2.9 (VCC_RF), R17.1
unnamed: C25.1, IC5.8 (CLKTUNE), R19.1
unnamed: C31.2, IC5.12 (VCOTUNE), R20.2
unnamed: C23.2, C24.1, C25.2, IC5.9 (VDDCLK)
unnamed: C37.1, IC5.44 (VDDDIG)
unnamed: C27.1, IC5.7 (VDDIF)
unnamed: C45.1, IC5.31 (VDDIO_1), R22.1, R23.1
unnamed: C38.1, IC5.42 (VDDIO_2)
unnamed: C30.1, IC5.6 (VDDMS)
unnamed: C39.1, IC5.20 (VDDREG)
unnamed: C26.2, IC5.10 (VDDSYN)
unnamed: C29.1, C31.1, C32.1, IC5.11 (VDDVCO)
unnamed: IC5.5 (VREF), R18.1
unnamed: C11.1, IC5.4 (XTAL2), Y2.1 (CRYSTAL_1)
unnamed: IC6.12 (ILIM), R37.2
unnamed: IC6.16 (ISET), R36.1
unnamed: IC6.1 (TS), R3.2
unnamed: Q1.3 (D), R34.2
unnamed: Q1.1 (G), R30.1, R31.1, R32.2
unnamed: Q2.2 (G), R33.1, R34.1
unnamed: R29.2, SW1.1
unnamed: R2.2, S1.B2 (NO_2)
unnamed: R29.1, R30.2, U3.3 (Q)
unnamed: C6.2, L1.2, L2.2, U5.H23 (ANT)
unnamed: C71.1, U5.A18 (DEC2)
unnamed: C64.2, U5.N24 (DEC5)
unnamed: C17.1, U5.AC5 (DECUSB)
unnamed: C60.2, U7.1 (VINA), U7.12 (EN), U7.13 (PS/SYNC)
unnamed: R35.2, R40.1, U7.3 (FB)
unnamed: L5.1, U7.8 (L1), U7.9 (L1_2)
unnamed: L5.2, U7.6 (L2), U7.7 (L2_2)
unnamed: R16.2, TP19.1, U7.14 (PG)
POWER_OFF: S1.A2 (COM_2), U4.2
