eSpark-Consulting-Group/kurtvogel-athletitech-hw/(commit log)

2025-04-07 #3 Updated power and charger sheet (in progress )
2025-04-08 #3 Updated schematic (power, charger,GPS,IMU,MagneticSensor,MCU,UWB) sheets (in progress)
2025-04-09 #3 Updated Power,GPS,IMU,MCU,UWB,MAGNETO sheets
2025-04-10 #3 updated schematic design
2025-04-10 #3 updated Schematic design (replaced power latch IC with analog switch based scheme) Done
2025-04-14 #4 (minor schematic changes done ) Component placement updated
2025-04-15 #4 Updated boost converter, Power sheet, Updated PCB component placement(in progress)
2025-04-16 #4 Updated PCB design (in progress)
2025-04-18 #3 updated capacitor footprint, component placement updated
2025-04-28 #5 updated schematic design
